irudoy/canlogger/docs/reference/README.md

# Reference Documentation

## MLVLG Format Specification (official)

- [MLG_Binary_LogFormat_2.0.pdf](MLG_Binary_LogFormat_2.0.pdf) — MLVLG v2 spec (Logger Field = 89 bytes with Category, Info Data Start = 4 bytes)

Author: Philip Tobin (EFI Analytics / TunerStudio / MegaLogViewer)

### Display value formula

```
DisplayValue = (rawValue + transform) * scale
rawValue = DisplayValue / scale - transform
```

### CRC

1-byte overflow sum of all data bytes in Logger Field Record (not including block type, counter, timestamp header).

### Timestamp in data blocks

2-byte timestamp at 10 us/bit resolution.

## rusefi Reference Implementation

Canonical MLG writer in [rusefi/rusefi](https://github.com/rusefi/rusefi/tree/master/firmware/console/binary_mlg_log) — `rusefi_mlg_types.h`, `rusefi_mlg_field.h`, `rusefi_binary_mlg_logging.{h,cpp}`.

## Hardware

- [STM32F407VET6-STM32_F4VE_V2.0_schematic.pdf](STM32F407VET6-STM32_F4VE_V2.0_schematic.pdf) — Board schematic

### Board features (from schematic)

- MCU: STM32F407VET6 (196K RAM, 512K Flash, 168MHz)
- Power: AMS1117-3.3V regulator, 5V input via header
- Crystals: 8MHz HSE (Y2), 32.768KHz LSE (Y1) for RTC
- SD card: MiniSD slot (U5) via SDIO
- USB: Mini USB (J4) as slave
- JTAG/SWD: 20-pin JTAG header (P1)
- ISP: UART1 (PA9 TX, PA10 RX) via 4-pin header (J6)
- NRF2401: 4-pin dual-row header (JP2)
- External Flash: W25Q16 (U3) SPI
- LEDs: D1, D2, D3 (active low)
- Buttons: K0, K1 (active low with pull-up), K_UP (active high), RST
- TFT LCD: 24x2 dual-row headers (J2, J3) + 16x2 header (J1)
- Boot mode: configurable via BOOT0/BOOT1 resistors
