irudoy/canlogger/docs/CONFIG_GUIDE.md

# CAN Logger: Configuration & MLG Format Guide

## Quick Start

1. Create `config.ini` on FAT32-formatted SD card (root directory)
2. Insert SD card into the logger
3. Power on — LED D2 blinks = logging active
4. Power off, eject SD — open `.mlg` files in [MegaLogViewer](https://www.efianalytics.com/MegaLogViewer/)

If there is no `config.ini` or it has errors, LEDs will indicate an error (see [HARDWARE.md](HARDWARE.md)).

## Config File Format

The config file uses INI-like syntax. It has one `[logger]` section and one or more `[field]` sections.

```ini
[logger]
interval_ms = 50
can_bitrate = 500000

[field]
can_id = 0x666
name = Coolant Temp
units = C
start_byte = 1
bit_length = 8
type = U08
scale = 1.0
offset = -40.0
digits = 0
category = Engine
```

Comments start with `#` and are ignored.

### [logger] Section

| Key | Required | Default | Description |
|-----|---|---|---|
| `interval_ms` | yes | -- | How often to write a data record (ms). 50 = 20 Hz, 10 = 100 Hz |
| `can_bitrate` | no | 500000 | CAN bus speed. Allowed: 125000, 250000, 500000, 1000000 |

### [field] Sections

Each `[field]` section defines one logged parameter. The order of sections determines the order of fields in the MLG file and in MegaLogViewer.

| Key | Required | Default | Description |
|-----|---|---|---|
| `can_id` | yes | -- | CAN ID to listen for (hex `0x...` or decimal) |
| `is_extended` | no | 0 | 1 = 29-bit extended ID (CAN 2.0B), 0 = 11-bit standard. Required for AEMnet and other extended-frame sources |
| `name` | yes | -- | Parameter name shown in MegaLogViewer (max 33 chars) |
| `units` | yes | -- | Units label (max 9 chars) |
| `start_byte` | yes | -- | Byte position in CAN data payload (0--7) |
| `start_bit` | no | 0 | Bit-within-byte position (0--7), only for sub-byte fields (`bit_length < 8`) |
| `bit_length` | yes | -- | Data width in bits: 1--7 (sub-byte), 8, 16, 32, or 64 |
| `type` | yes | -- | Data type: `U08`, `S08`, `U16`, `S16`, `U32`, `S32`, `S64`, `F32` |
| `scale` | yes | -- | Display multiplier: `display = raw * scale + offset` |
| `offset` | yes | -- | Display offset |
| `is_big_endian` | no | 0 | Byte order in CAN frame: 0 = little-endian, 1 = big-endian. Ignored for sub-byte fields |
| `digits` | no | 0 | Decimal places in MegaLogViewer |
| `display_style` | no | 0 | 0=Float, 1=Hex, 2=Bits, 4=On/Off, 5=Yes/No, 6=High/Low |
| `category` | no | *(empty)* | Group name in MegaLogViewer (max 33 chars) |
| `lut` | no | -- | Lookup table for non-linear conversion (see below) |
| `valid_min` | no | -- | Reject frames where the computed display value falls below this threshold |
| `valid_max` | no | -- | Reject frames where the computed display value exceeds this threshold |
| `invalid_strategy` | no | `last_good` | What to do on rejection: `last_good` (keep previous value), `clamp` (saturate to min/max), `skip` (do not update shadow buffer) |
| `preset` | no | `none` | Plug-in sensor-fault detector. `aem_uego` rejects raw `0xFFFF` on a 16-bit field (AEM X-Series warmup/free-air-cal/sensor-fault marker). Applies *before* `valid_min/max` |

### Constraints

- Maximum 256 fields total, up to 28 unique CAN IDs (hardware filter limit)
- `start_byte + bit_length/8` must not exceed 8 (CAN frame is 8 bytes)
- Sub-byte fields (`bit_length` 1--7) must use `type = U08` or `S08`, and `start_bit + bit_length <= 8`
- `start_bit` is only valid for sub-byte fields (`bit_length < 8`); non-zero `start_bit` with byte-aligned `bit_length` is rejected
- The same `can_id` must not appear with conflicting `is_extended` flags
- Multiple fields can reference the same `can_id`
- Field names must be unique

## Data Conversion: scale & offset

The logger stores raw integer values extracted from CAN data. MegaLogViewer displays them using:

```
DisplayValue = raw * scale + offset
```

**Examples:**

| Sensor | Raw range | Scale | Offset | Display range |
|---|---|---|---|---|
| Battery voltage | 0--255 | 0.08 | 0 | 0--20.4 V |
| Coolant temp (Nissan) | 0--255 | 1.0 | -50.0 | -50--205 C |
| RPM (16-bit) | 0--65535 | 12.5 | 0 | 0--819187 rpm |
| Ignition timing | 0--255 | -1.0 | -110.0 | -110--145 deg |

## Lookup Tables (LUT)

For non-linear sensors (NTC thermistors, non-linear pressure sensors), use a lookup table instead of simple scale/offset.

```ini
lut = input1:output1, input2:output2, ...
```

- `input` -- raw value from CAN (unsigned 16-bit, e.g. millivolts from ADC)
- `output` -- display value (signed 16-bit, e.g. degrees C)
- 2 to 16 points, sorted by ascending input
- Linear interpolation between points, clamped outside range
- When LUT is present, `scale`/`offset` are still required -- they define how the display value is stored in MLG format (`stored = display / scale - offset`)

### Example: NTC thermistor (Bosch 0261230042, 2.2k pull-up)

```ini
[field]
can_id = 0x640
name = IAT
units = C
start_byte = 0
bit_length = 16
type = S16
scale = 0.1
offset = 0.0
is_big_endian = 1
digits = 0
category = Sensors
lut = 192:120, 325:100, 428:90, 570:80, 760:70, 1014:60, 1346:50, 1765:40, 2259:30, 2807:20, 3353:10, 3848:0, 4543:-20, 4860:-40
```

Raw 2259 mV -> 30 C, raw 3000 mV -> interpolated ~16 C, raw 100 mV -> clamped 120 C.

### Example: linear MAP sensor (2-point LUT from datasheet)

```ini
[field]
can_id = 0x640
name = MAP
units = kPa
start_byte = 2
bit_length = 16
type = U16
scale = 1.0
offset = 0.0
is_big_endian = 1
digits = 0
category = Sensors
lut = 400:20, 4650:250
```

## Byte Order (Endianness)

CAN data bytes can be in little-endian (LSB first) or big-endian (MSB first) order depending on the source ECU.

- `is_big_endian = 0` (default): bytes `[low, high]` -- common in many aftermarket ECUs
- `is_big_endian = 1`: bytes `[high, low]` -- common in OEM ECUs, Nissan Consult

For 8-bit fields (`bit_length = 8`), endianness does not matter.

## Extended (29-bit) CAN IDs

Standard CAN frames use 11-bit IDs (0x000--0x7FF). CAN 2.0B extended frames use 29-bit IDs and are distinguished by the IDE bit on the wire. Sources like AEMnet (AEM gauges) and J1939 use extended IDs.

Set `is_extended = 1` to configure the hardware filter for extended frames. The same numeric `can_id` value can exist in the standard and extended ID spaces independently, so always set this flag explicitly when the source documentation specifies extended addressing.

```ini
# AEM X-Series UEGO 30-0300, AEMnet extended ID 0x180
[field]
can_id = 0x180
is_extended = 1
name = Lambda
units = λ
start_byte = 0
bit_length = 16
type = U16
is_big_endian = 1
scale = 0.0001
offset = 0.0
digits = 4
category = AEM UEGO
```

## Sub-byte (bit-level) Fields

For digital flags packed inside a single byte (ECU status bits, solenoid states, DTCs), declare each bit as its own field with `bit_length = 1` and an explicit `start_bit`.

```ini
# Nissan Consult BIT_1 register — byte 0 of 0x668
[field]
can_id = 0x668
name = Throttle Closed
units = bool
start_byte = 0
start_bit = 0       # bit 0
bit_length = 1
type = U08
scale = 1.0
offset = 0.0
category = Cansult

[field]
can_id = 0x668
name = Neutral Switch
units = bool
start_byte = 0
start_bit = 2       # bit 2
bit_length = 1
type = U08
scale = 1.0
offset = 0.0
category = Cansult
```

Bit ordering is LSB = bit 0. Sub-byte fields produce raw 0/1 values in the MLG; use `display_style = 4` (On/Off) or `5` (Yes/No) for nicer rendering in MegaLogViewer.

## Plausibility Filtering

CAN sources without per-frame integrity protection (Nissan Consult, raw OBD streams, hobbyist gauges) can emit impossible values when a single UART or bit-stuff byte is shifted. Raw RPM of 745 663 and AFR of 96 on decel fuel-cut are both real examples from production logs. MegaLogViewer auto-scales the timeline to those spikes, making the useful range unreadable.

Add three optional keys per field:

- `valid_min`, `valid_max` — bounds expressed in **display units** (the value after `scale`, `offset`, and any `lut` is applied).
- `invalid_strategy` — how to treat a rejected sample:
  - `last_good` (default) — shadow buffer keeps the previous known-good value; the MLG stream receives a flat-line until a plausible frame arrives.
  - `clamp` — saturate the value to whichever bound was crossed. Useful when you want the chart to show "at limit" rather than a gap.
  - `skip` — do not update the shadow buffer at all. Identical to `last_good` in the current writer (shadow stays), kept as an explicit intent marker for future per-field change-detection.

Sensor-specific fault encodings that cannot be expressed as a bound are handled by presets:

- `preset = aem_uego` — on a 16-bit field, rejects raw `0xFFFF`. AEM X-Series UEGO gauges emit this value during warmup, free-air calibration, and any sensor fault; without it decel fuel-cut produces a spike of AFR ≈ 96.

```ini
# AEM UEGO: reject sensor-fault marker and clamp physical range
[field]
can_id = 0x180
is_extended = 1
name = AFR
units = :1
start_byte = 0
bit_length = 16
type = U16
is_big_endian = 1
scale = 0.001465
preset = aem_uego
valid_min = 7
valid_max = 22
invalid_strategy = last_good

# RPM: any value > 9000 is a UART framing shift on the cansult side
[field]
can_id = 0x667
name = RPM
units = rpm
start_byte = 1
bit_length = 16
type = U16
is_big_endian = 1
scale = 12.5
valid_max = 9000
invalid_strategy = last_good
```

Order of evaluation: extract → preset check → LUT → valid_min/max check → write to shadow (or apply strategy).

## GPS

The logger supports an optional u-blox NEO-6M (or compatible NMEA-0183) receiver wired to USART3 at 9600 8N1. When enabled, GPS fields appear in the MLG file alongside CAN fields.

### Enable block

Adding `[gps] enable = 1` turns the feature on and auto-injects a minimal set of GPS fields at the end of the `[field]` list:

```ini
[gps]
enable = 1
```

| Auto-injected field | Type | Units | Source |
|---|---|---|---|
| `gps_lat` | F32  | deg | $xxGGA / $xxRMC — decimal degrees, south negative |
| `gps_lon` | F32  | deg | $xxGGA / $xxRMC — decimal degrees, west negative  |
| `gps_alt` | F32  | m | $xxGGA altitude MSL |
| `gps_speed_kmh` | F32  | km/h  | $xxRMC speed (knots converted) |
| `gps_fix` | U08  | -- | 0 = no fix, 1 = GPS, 2 = DGPS, 6 = estimated |

Each field's value stays at its previous reading until the corresponding NMEA sentence arrives with a valid fix — so `gps_lat` reads 0 on boot and flips to the receiver's decimal-degree output once the module acquires satellites. `gps_fix = 0` is the reliable signal that the other fields aren't trustworthy yet.

### Extra GPS fields via `source = gps:*`

To log additional GPS data beyond the five defaults, add `[field]` sections with `source = gps:<tag>` in place of `can_id`. The parser skips the CAN-frame geometry checks for these fields.

```ini
[field]
name = gps_sats
units = cnt
type = U08
source = gps:sats

[field]
name = gps_hdop
units = --
type = F32
digits = 1
source = gps:hdop

[field]
name = gps_course
units = deg
type = F32
digits = 1
source = gps:course
```

Supported tags: `lat`, `lon`, `alt`, `speed_ms`, `speed_kmh`, `course`, `sats`, `hdop`, `fix`, `year`, `month`, `day`, `hour`, `minute`, `second`.

Declaring `source = gps:lat` (or any of the five defaults) suppresses the auto-inject for that slot, so your customized field replaces the default — use this to change the type, digits, name, or apply a non-unit `scale`.

### One-shot RTC sync

On the first NMEA sentence with both a valid fix and a full date+time, the firmware syncs the RTC once per boot. CDC `settime` still works as a manual override; the auto-sync does not fight it after it has fired once.

### CDC commands

- `gps` — one-shot snapshot of the parsed state: fix quality, satellite count, lat/lon, altitude, speed, course, HDOP, UTC timestamp, and parser counters (ok / bad-checksum / ignored / line-buffer overflow).
- `gps_raw` — toggle: when ON, every byte received on USART3 is echoed to the CDC stdout. Useful for diagnosing antenna / cabling issues before you rely on parser output.

## Choosing the Right Data Type

| CAN data | Type | Bit length | Notes |
|---|---|---|---|
| Unsigned byte (0--255) | `U08` | 8 | Most common for single-byte values |
| Signed byte (-128--127) | `S08` | 8 | Temperature with negative range |
| Unsigned 16-bit (0--65535) | `U16` | 16 | RPM, injection time, ADC values |
| Signed 16-bit (-32768--32767) | `S16` | 16 | Temperature from LUT |
| Unsigned 32-bit | `U32` | 32 | Odometer, counters |
| Signed 32-bit | `S32` | 32 | |
| Signed 64-bit | `S64` | 64 | Uses full CAN frame |
| 32-bit float | `F32` | 32 | IEEE 754 floating point |

## MLG File Format (for users)

The logger writes `.mlg` files in **MLVLG v2** format, compatible with [MegaLogViewer](https://www.efianalytics.com/MegaLogViewer/) (free and HD versions).

- Files are named sequentially: `LOG_0001.MLG`, `LOG_0002.MLG`, ...
- File rotation at 4 MB -- new file is started automatically
- All data is big-endian
- Each data record contains a snapshot of all field values at the time of writing

### Opening in MegaLogViewer

1. File -> Open Log File -> select `.mlg` file
2. All configured fields appear in the field list with their names, units, and categories
3. Drag fields to the graph area to plot
4. Use categories to group related fields

### Display formula

MegaLogViewer applies the formula from the MLG header:

```
DisplayValue = (storedValue + transform) * scale
```

This is set up automatically by the logger from your config -- you don't need to configure anything in MegaLogViewer.

### Built-in `Date` field and HH:MM:SS via calculated fields

Each record includes a synthetic `Date` field (U32 unix timestamp, `MLG_DATE`
display style). MegaLogViewer renders it as a calendar date only (e.g.
`Apr 14, 2026`) — the MLG spec has no native HH:MM:SS style.

To display the wall-clock time, add **calculated fields** in your viewer.
Calculated fields are numeric only — string formatting like `"HH:MM:SS"` is
not supported by either viewer.

#### MegaLogViewer (Optional Fields → Custom Fields)

MLV supports the `%` (modulo) operator.

Single packed HHMMSS integer — one row in the value panel:

```
TimeHHMMSS = floor(([Date] % 86400) / 3600) * 10000
           + floor(([Date] % 3600)  / 60)   * 100
           + ([Date] % 60)
```

Displays as `171642`, read as `17:16:42`.

Three separate fields — three rows, each a plain number (`17`, `16`, `42`):

```
Hour   = floor(([Date] % 86400) / 3600)
Minute = floor(([Date] % 3600)  / 60)
Second = [Date] % 60
```

#### UltraLog (Computed Channels)

UltraLog's expression engine (`meval`) supports `floor`/`ceil`/`round`/`trunc`
but **does not have a `%` operator** — use `x - floor(x/y)*y` for modulo.

Single packed HHMMSS integer:

```
TimeHHMMSS = floor((Date - floor(Date/86400)*86400) / 3600) * 10000
           + floor((Date - floor(Date/3600)*3600)   / 60)   * 100
           + (Date - floor(Date/60)*60)
```

Three separate fields:

```
Hour   = floor((Date - floor(Date/86400)*86400) / 3600)
Minute = floor((Date - floor(Date/3600)*3600)   / 60)
Second = Date - floor(Date/60)*60
```

## Complete Example: Nissan Consult via cansult

This config logs 11 parameters from a Nissan ECU using the [cansult](../cansult/) bridge (Consult protocol -> CAN bus).

```ini
[logger]
interval_ms = 50
can_bitrate = 500000

# Connection state
[field]
can_id = 0x665
name = State
units = raw
start_byte = 0
bit_length = 8
type = U08
scale = 1.0
offset = 0.0
digits = 0
category = Cansult

# Battery voltage: raw 0-255, display 0-20.4V
[field]
can_id = 0x666
name = Battery
units = V
start_byte = 0
bit_length = 8
type = U08
scale = 0.08
offset = 0.0
digits = 1
category = Engine

# Coolant temperature: raw 0-255, display -50 to 205 C
[field]
can_id = 0x666
name = Coolant
units = C
start_byte = 1
bit_length = 8
type = U08
scale = 1.0
offset = -50.0
digits = 0
category = Engine

# RPM: 16-bit big-endian, raw * 12.5 = RPM
[field]
can_id = 0x667
name = RPM
units = rpm
start_byte = 1
bit_length = 16
type = U16
scale = 12.5
offset = 0.0
is_big_endian = 1
digits = 0
category = Engine

# Vehicle speed: raw * 2 = km/h
[field]
can_id = 0x667
name = Speed
units = km/h
start_byte = 0
bit_length = 8
type = U08
scale = 2.0
offset = 0.0
digits = 0
category = Vehicle
```

## Troubleshooting

| Symptom | Cause | Fix |
|---|---|-----|
| LED error on startup | No `config.ini` on SD root | Create config file, check FAT32 format |
| LED error on startup | Syntax error in config | Check field names, missing values, typos |
| All values zero | Wrong `can_id` | Verify CAN IDs from your source device |
| Values look wrong | Wrong `is_big_endian` | Try toggling between 0 and 1 |
| Values look wrong | Wrong `scale`/`offset` | Check ECU documentation for conversion formula |
| Values look wrong | Wrong `start_byte` | Verify byte position in CAN data payload |
| No log files | SD card issue | Use FAT32-formatted card, check contacts |
| Short log files | Power loss | Use stable power supply, graceful shutdown with K1 button |
