irudoy/canlogger/docs/ppk-measurements/ppk-20260410T144323.png

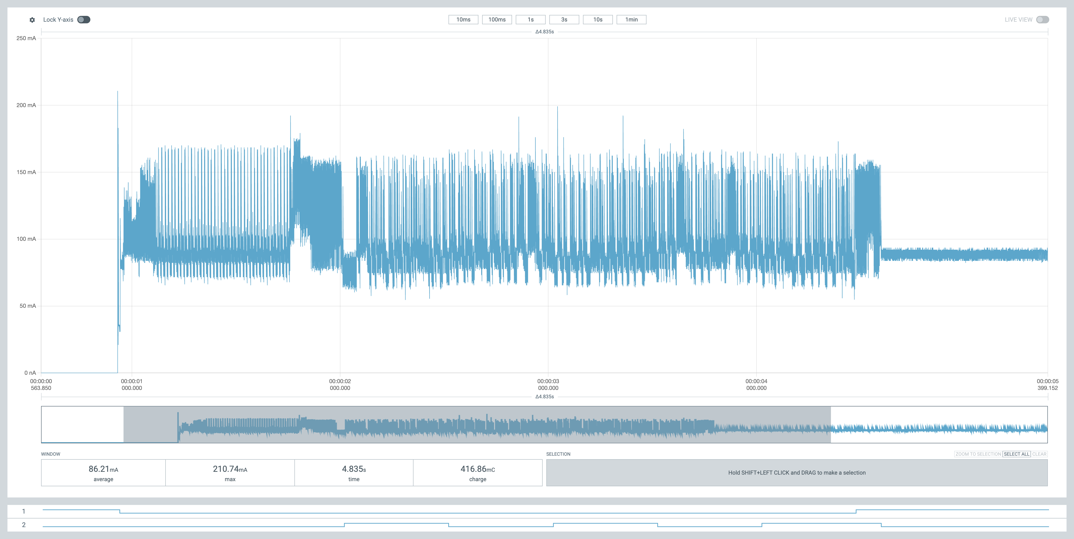
docs/ppk-measurements/ppk-20260410T144323.png
