irudoy/canlogger/docs/ppk-measurements/ppk-20260410T144636.png

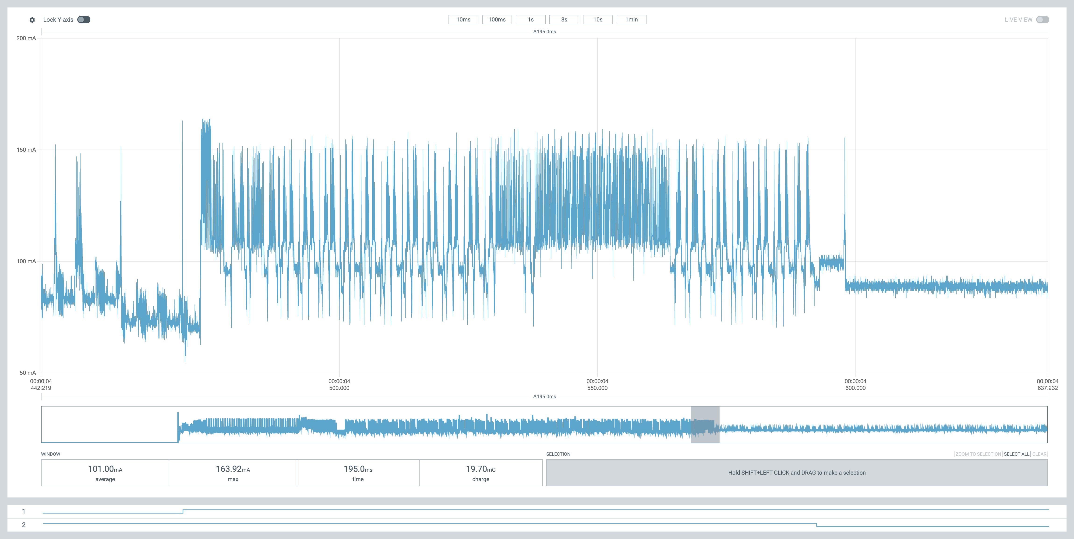
docs/ppk-measurements/ppk-20260410T144636.png
