irudoy/canlogger/docs/ppk-measurements/ppk-20260410T145153.png

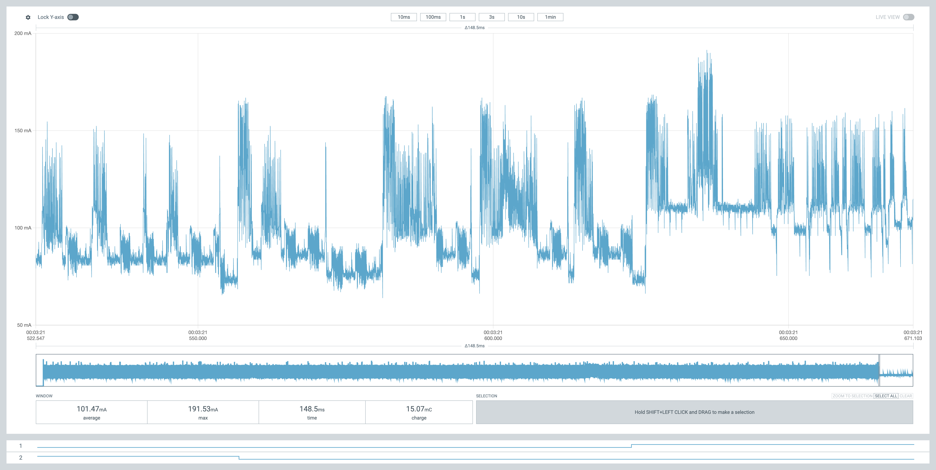
docs/ppk-measurements/ppk-20260410T145153.png
