irudoy/canlogger/firmware/Src/main.c

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
/* Includes ------------------------------------------------------------------*/
#include "main.h"
#include "cmsis_os.h"
#include "fatfs.h"
#include "usb_device.h"

/* USER CODE BEGIN Includes */
#include <string.h>
#include "log_writer.h"
#include "can_drv.h"
#include "ring_buf.h"
#include "can_map.h"
#include "debug_out.h"
#include "demo_gen.h"
#include "demo_can.h"
#include "vin_sense.h"
#include "bkp_log.h"
#include "gps_drv.h"
/* USER CODE END Includes */

/* USER CODE BEGIN PD */
#define VIN_SENSE_CHECK_MS    100   /* poll interval */
/* USER CODE END PD */

ADC_HandleTypeDef hadc1;

CAN_HandleTypeDef hcan1;

RTC_HandleTypeDef hrtc;

SD_HandleTypeDef hsd;
DMA_HandleTypeDef hdma_sdio_rx;
DMA_HandleTypeDef hdma_sdio_tx;

UART_HandleTypeDef huart3;
DMA_HandleTypeDef hdma_usart3_rx;

/* Definitions for defaultTask */
osThreadId_t defaultTaskHandle;
const osThreadAttr_t defaultTask_attributes = {
  .name = "defaultTask",
  .stack_size = 512 * 4,
  .priority = (osPriority_t) osPriorityNormal,
};
/* USER CODE BEGIN PV */
volatile uint8_t lw_shutdown = 0;
volatile uint8_t sd_stopped = 0;  // set by task_sd after lw_stop completes
volatile uint8_t vin_triggered_shutdown = 0;  // 1 = VIN outage (auto-resume), 0 = CDC `stop`
// Marker request: 0=none, 1=K0 press ("btn"), 2=CDC `mark` (marker_cdc_text).
// Set by EXTI ISR or CDC task, consumed by task_sd.
volatile uint8_t marker_request = 0;
char marker_cdc_text[50];  // filled by CDC before setting marker_request=2
static ring_Buffer can_rx_buf;
static cfg_Config config __attribute__((section(".ccmram")));
static can_FieldValues field_values;
static uint32_t can_frames_processed = 0;
volatile int init_ok = 0;
// Demo mode helper arrays (extracted from config for demo_generate)
static uint8_t demo_field_types[CFG_MAX_FIELDS];
static float demo_field_scales[CFG_MAX_FIELDS];
static float demo_field_offsets[CFG_MAX_FIELDS];

// FreeRTOS: shadow mutex guards field_values between task_producer and task_sd
osMutexId_t shadow_mutex;
static const osMutexAttr_t shadow_mutex_attr = {
  .name = "shadowMutex"
};

// FreeRTOS: SD writer task
osThreadId_t sdTaskHandle;
static const osThreadAttr_t sdTask_attributes = {
  .name = "sdTask",
  .stack_size = 4096,
  .priority = (osPriority_t) osPriorityBelowNormal,
};
void SdTaskEntry(void *argument);
/* USER CODE END PV */

void SystemClock_Config(void);
static void MX_GPIO_Init(void);
static void MX_DMA_Init(void);
static void MX_CAN1_Init(void);
static void MX_SDIO_SD_Init(void);
static void MX_RTC_Init(void);
static void MX_ADC1_Init(void);
static void MX_USART3_UART_Init(void);
void StartDefaultTask(void *argument);

static void MX_NVIC_Init(void);
/* USER CODE BEGIN 0 */
void HAL_GPIO_EXTI_Callback(uint16_t GPIO_Pin) {
  if (GPIO_Pin == USR_BTN_3_K1_Pin) {
    lw_shutdown = 1;
    HAL_GPIO_WritePin(LED_1_GPIO_Port, LED_1_Pin, GPIO_PIN_SET); // D2 off (active-low)
  } else if (GPIO_Pin == USR_BTN_4_K0_Pin) {
    // Debounce: any edge (including release-bounce that also trips FALLING)
    // extends the blackout. Window must exceed typical hold + release time.
    static uint32_t k0_last_tick = 0;
    uint32_t now = HAL_GetTick();
    uint32_t since = now - k0_last_tick;
    k0_last_tick = now;
    if (since < 300) return;
    if (marker_request == 0) marker_request = 1;  // drop if SD hasn't consumed yet
  }
}
/* USER CODE END 0 */

/**
  * @brief  The application entry point.
  * @retval int
  */
int main(void)
{

  /* MCU Configuration--------------------------------------------------------*/

  /* Reset of all peripherals, Initializes the Flash interface and the Systick. */
  HAL_Init();

  /* Configure the system clock */
  SystemClock_Config();

  /* Initialize all configured peripherals */
  MX_GPIO_Init();
  MX_DMA_Init();
  MX_CAN1_Init();
  MX_SDIO_SD_Init();
  MX_FATFS_Init();
  MX_RTC_Init();
  MX_ADC1_Init();
  MX_USART3_UART_Init();

  /* Initialize interrupts */
  MX_NVIC_Init();
  /* USER CODE BEGIN 2 */
  bkp_log_init();  // increment session counter in BKP_DR1
  ring_buf_init(&can_rx_buf);
  /* SD/FatFS init moved to StartDefaultTask — requires scheduler running
   * (RTOS sd_diskio template checks osKernelGetState before BSP_SD_Init). */
  /* USER CODE END 2 */

  /* Init scheduler */
  osKernelInitialize();

  /* USER CODE BEGIN RTOS_MUTEX */
  shadow_mutex = osMutexNew(&shadow_mutex_attr);
  /* USER CODE END RTOS_MUTEX */

  /* USER CODE BEGIN RTOS_SEMAPHORES */
  /* add semaphores, ... */
  /* USER CODE END RTOS_SEMAPHORES */

  /* USER CODE BEGIN RTOS_TIMERS */
  /* start timers, add new ones, ... */
  /* USER CODE END RTOS_TIMERS */

  /* USER CODE BEGIN RTOS_QUEUES */
  /* add queues, ... */
  /* USER CODE END RTOS_QUEUES */

  /* Create the thread(s) */
  /* creation of defaultTask */
  defaultTaskHandle = osThreadNew(StartDefaultTask, NULL, &defaultTask_attributes);

  /* USER CODE BEGIN RTOS_THREADS */
  sdTaskHandle = osThreadNew(SdTaskEntry, NULL, &sdTask_attributes);
  /* USER CODE END RTOS_THREADS */

  /* USER CODE BEGIN RTOS_EVENTS */
  /* add events, ... */
  /* USER CODE END RTOS_EVENTS */

  /* Start scheduler */
  osKernelStart();

  /* We should never get here as control is now taken by the scheduler */

  /* Infinite loop */
  /* USER CODE BEGIN WHILE */
  while (1)
  {
    /* Dead code — scheduler never returns. Kept for CubeMX marker compliance. */
    /* USER CODE END WHILE */

    /* USER CODE BEGIN 3 */
  }
  /* USER CODE END 3 */
}

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
/* USER CODE BEGIN 4 */
void SdTaskEntry(void *argument)
{
  (void)argument;
  static uint8_t snapshot[CAN_MAP_MAX_RECORD_SIZE];
  uint32_t next_wake = 0;

  while (!lw_shutdown) {
    if (!init_ok || lw_is_error()) {
      osDelay(100);
      next_wake = 0;  // reset periodic base after wait
      continue;
    }

    // Periodic timing via osDelayUntil — drift-free
    if (next_wake == 0) {
      next_wake = osKernelGetTickCount();
    }
    next_wake += config.log_interval_ms;
    osDelayUntil(next_wake);

    if (lw_shutdown) break;

    // Snapshot shadow buffer under mutex
    osMutexAcquire(shadow_mutex, osWaitForever);
    size_t rec_len = field_values.record_length;
    memcpy(snapshot, field_values.values, rec_len);
    osMutexRelease(shadow_mutex);

    // Marker drained before snapshot so it lands at the chronologically
    // correct spot between data blocks.
    if (marker_request) {
      const char* msg = (marker_request == 2) ? marker_cdc_text : "btn";
      lw_write_marker(msg);
      marker_request = 0;
    }

    lw_write_snapshot(snapshot, rec_len);
  }

  // Graceful shutdown: flush and close
  if (init_ok) lw_stop();

  // Signal task_producer that SD is fully flushed — safe to reset MCU now.
  sd_stopped = 1;
  osThreadExit();
}
/* USER CODE END 4 */

/* USER CODE BEGIN Header_StartDefaultTask */
/**
  * @brief  Function implementing the defaultTask thread.
  * @param  argument: Not used
  * @retval None
  */
/* USER CODE END Header_StartDefaultTask */
void StartDefaultTask(void *argument)
{
  /* init code for USB_DEVICE */
  MX_USB_DEVICE_Init();
  /* USER CODE BEGIN 5 */
  // Init SD, read config, write MLG header (must run after scheduler start —
  // RTOS sd_diskio template requires osKernelRunning for BSP_SD_Init)
  init_ok = (lw_init(&config, &field_values) == 0);

  gps_drv_init();

  // Extract field metadata for demo generator
  if (init_ok && config.demo) {
    for (int i = 0; i < config.num_fields; i++) {
      demo_field_types[i] = config.fields[i].type;
      demo_field_scales[i] = config.fields[i].scale;
      demo_field_offsets[i] = config.fields[i].offset;
    }
  }

  if (init_ok) {
    if (config.num_can_ids > 0) {
      can_drv_init(&can_rx_buf, &config);
      can_drv_start();
    }
  } else {
    config.can_bitrate = 500000;
    config.num_can_ids = 0;
    can_drv_init(&can_rx_buf, &config);
    can_drv_start();
  }

  /* task_producer: drain CAN ring buffer, update shadow, handle debug CLI */
  for(;;)
  {
    if (lw_shutdown) {
      can_drv_stop();
      // Wait for task_sd to flush SD before MCU reset — resetting mid-write
      // corrupts the file. Cap wait at 2s: if lw_stop wedges (card removed,
      // HAL stuck), reset anyway so we don't drain the supercap forever.
      uint32_t deadline = HAL_GetTick() + 2000;
      while (!sd_stopped && HAL_GetTick() < deadline) osDelay(10);

      // CDC `stop` (vin_triggered_shutdown=0) just halts — user wants to
      // flash or remove the card. VIN-triggered shutdown waits for power
      // to return, then resets so logging auto-resumes.
      if (!vin_triggered_shutdown) osThreadExit();

      int high_count = 0;
      for (;;) {
        osDelay(VIN_SENSE_CHECK_MS);
        vin_sense_poll();
        if (vin_sense_mv >= VIN_SENSE_THRESHOLD_MV) {
          if (++high_count >= 3) NVIC_SystemReset();
        } else {
          high_count = 0;
        }
      }
    }

    // Pack demo data into CAN frames (if demo + ring buf mode)
    if (init_ok && config.demo && config.demo_gen.use_ring_buf) {
      demo_pack_can_frames(&config, &can_rx_buf, HAL_GetTick());
    }

    // Drain GPS DMA outside shadow_mutex: gps_drv_poll() touches only
    // task_producer-local state, and when `gps_raw` is ON it also does
    // per-byte putchar() to CDC — holding shadow_mutex through that stalls
    // task_sd's field_values snapshot for the duration of the USB TX.
    gps_drv_poll();

    // Drain CAN ring buffer → update shadow under mutex
    {
      can_Frame frame;
      osMutexAcquire(shadow_mutex, osWaitForever);
      if (init_ok && config.gps_enabled) {
        can_map_update_gps(&field_values, &config, gps_drv_state());
      }
      while (ring_buf_pop(&can_rx_buf, &frame) == 0) {
        if (init_ok) can_map_process(&field_values, &config, &frame);
        can_frames_processed++;
        debug_out_set_can(frame.id, frame.data, frame.dlc);
      }
      // Direct demo for fields without CAN IDs (legacy path)
      if (init_ok && config.demo && !config.demo_gen.use_ring_buf) {
        demo_generate(&config.demo_gen,
                      field_values.values, field_values.record_length,
                      demo_field_types, demo_field_scales, demo_field_offsets,
                      config.num_fields, HAL_GetTick());
        field_values.updated = 1;
      }
      osMutexRelease(shadow_mutex);
    }

    // One-shot RTC sync on first GPS fix with date+time. `gps_rtc_synced`
    // latches for the life of this boot so the loop doesn't keep re-setting
    // the RTC every iteration. CDC `settime` still works as a manual override.
    {
      static uint8_t gps_rtc_synced = 0;
      if (!gps_rtc_synced) {
        const gps_State* gs = gps_drv_state();
        if (gs->has_fix && gs->has_date && gs->has_time) {
          #define BCD(v) (uint8_t)(((v) / 10) << 4 | ((v) % 10))
          RTC_TimeTypeDef t = {
            .Hours = BCD(gs->hour), .Minutes = BCD(gs->minute), .Seconds = BCD(gs->second),
            .DayLightSaving = RTC_DAYLIGHTSAVING_NONE,
            .StoreOperation = RTC_STOREOPERATION_RESET,
          };
          RTC_DateTypeDef d = {
            .WeekDay = RTC_WEEKDAY_MONDAY,
            .Month = BCD(gs->month), .Date = BCD(gs->day),
            .Year = BCD(gs->year % 100),
          };
          #undef BCD
          if (HAL_RTC_SetTime(&hrtc, &t, RTC_FORMAT_BCD) == HAL_OK &&
              HAL_RTC_SetDate(&hrtc, &d, RTC_FORMAT_BCD) == HAL_OK) {
            gps_rtc_synced = 1;
          }
        }
      }
    }

    debug_out_tick(can_frames_processed, config.num_fields, init_ok);
    debug_cmd_poll(&config, init_ok, &can_rx_buf);
    lw_update_leds();

    // VIN_SENSE: check every VIN_SENSE_CHECK_MS
    {
      static uint32_t next_vin_check = 0;
      uint32_t now = HAL_GetTick();
      if (now >= next_vin_check) {
        vin_sense_poll();
        next_vin_check = now + VIN_SENSE_CHECK_MS;
      }
    }

    osDelay(1);
  }
  /* USER CODE END 5 */
}

/**
  * @brief  Period elapsed callback in non blocking mode
  * @note   This function is called  when TIM6 interrupt took place, inside
  * HAL_TIM_IRQHandler(). It makes a direct call to HAL_IncTick() to increment
  * a global variable "uwTick" used as application time base.
  * @param  htim : TIM handle
  * @retval None
  */
void HAL_TIM_PeriodElapsedCallback(TIM_HandleTypeDef *htim)
{
  if (htim->Instance == TIM6)
  {
    HAL_IncTick();
  }
}

/**
  * @brief  This function is executed in case of error occurrence.
  * @retval None
  */
void Error_Handler(void)
{
  /* USER CODE BEGIN Error_Handler_Debug */
  /* User can add his own implementation to report the HAL error return state */
  __disable_irq();
  while (1)
  {
  }
  /* USER CODE END Error_Handler_Debug */
}
#ifdef USE_FULL_ASSERT
/**
  * @brief  Reports the name of the source file and the source line number
  *         where the assert_param error has occurred.
  * @param  file: pointer to the source file name
  * @param  line: assert_param error line source number
  * @retval None
  */
void assert_failed(uint8_t *file, uint32_t line)
{
  /* USER CODE BEGIN 6 */
  /* User can add his own implementation to report the file name and line number,
     ex: printf("Wrong parameters value: file %s on line %d\r\n", file, line) */
  /* USER CODE END 6 */
}
#endif /* USE_FULL_ASSERT */
