irudoy/canlogger/firmware/canlogger.ioc

Mcu.UserName=STM32F407VETx
PA0-WKUP.Signal=ADCx_IN0
PA11.Signal=USB_OTG_FS_DM
PA12.Signal=USB_OTG_FS_DP
PA13.Signal=SYS_JTMS-SWDIO
PA14.Signal=SYS_JTCK-SWCLK
PA6.GPIO_Label=LED_1
PA6.Signal=GPIO_Output
PA7.GPIO_Label=LED_2
PA7.Signal=GPIO_Output
PB10.Signal=USART3_TX
PB11.Signal=USART3_RX
PB8.Signal=CAN1_RX
PB9.Signal=CAN1_TX
PC10.Signal=SDIO_D2
PC11.Signal=SDIO_D3
PC12.Signal=SDIO_CK
PC14-OSC32_IN.Signal=RCC_OSC32_IN
PC15-OSC32_OUT.Signal=RCC_OSC32_OUT
PC8.Signal=SDIO_D0
PC9.Signal=SDIO_D1
PD2.Signal=SDIO_CMD
PE3.GPIO_Label=USR_BTN_3_K1
PE3.Signal=GPXTI3
PE4.GPIO_Label=USR_BTN_4_K0
PE4.Signal=GPXTI4
PH0-OSC_IN.Signal=RCC_OSC_IN
PH1-OSC_OUT.Signal=RCC_OSC_OUT
