irudoy/canlogger/firmware/Inc/main.h

#define USR_BTN_3_K1_Pin GPIO_PIN_3
#define USR_BTN_3_K1_GPIO_Port GPIOE
#define USR_BTN_3_K1_EXTI_IRQn EXTI3_IRQn
#define USR_BTN_4_K0_Pin GPIO_PIN_4
#define USR_BTN_4_K0_GPIO_Port GPIOE
#define USR_BTN_4_K0_EXTI_IRQn EXTI4_IRQn
#define LED_1_Pin GPIO_PIN_6
#define LED_1_GPIO_Port GPIOA
#define LED_2_Pin GPIO_PIN_7
#define LED_2_GPIO_Port GPIOA
#define VIN_SENSE_THRESHOLD_MV 2000   /* ~4.0V DC-DC out (divider 1:2) */
