irudoy/canlogger/firmware/Src/log_writer.c

#include "log_writer.h"

#include <stdio.h>
#include <string.h>
#include "main.h"
#include "cmsis_os2.h"
#include "mlvlg.h"
#include "sd_write_dma.h"
#include "bkp_log.h"

#define LED1 1
#define LED2 2
#define LED_ON 0
#define LED_OFF 1
#define BLINK_INTERVAL_NORMAL 500
#define BLINK_INTERVAL_ERROR 100
#define MARKER_BLINK_INTERVAL 75
#define MARKER_BLINK_TOGGLES 2
#define MAX_FILE_SIZE (32 * 1024 * 1024)
#define MAX_ERROR_COUNT 5
#define CONFIG_FILE_NAME "config.ini"

extern RTC_HandleTypeDef hrtc;

typedef struct {
  uint8_t year, month, day, hour, minute, second;
} DateTime;

static FIL log_file_obj;
static char log_file_name[32];
static uint32_t last_tick_led1 = 0;
static uint32_t last_tick_led2 = 0;
static uint8_t marker_blink_remaining = 0;
static int error_state = 0;
static int paused = 0;
static uint32_t file_counter = 0;
static int error_count = 0;
static uint32_t recovery_count = 0;
static FRESULT last_error = FR_OK;
static const char* last_error_at = "";
// Reason for the most recent recover_file() trigger (even if recovery
// succeeded). Lets us tell f_sync failures apart from f_write failures.
static FRESULT last_rec_res = FR_OK;
static const char* last_rec_at = "";
static uint8_t block_counter = 0;
static uint32_t last_log_tick = 0;
// Flips to 1 after a successful f_sync in the current file's lifetime.
// Gates the truncate/sync calls in recover_file() — if we've never had a
// clean sync, the FAT state is suspect and further ops risk hanging SDIO.
static uint8_t had_clean_sync = 0;

// Pointer to config (set at init, used for MLG header writing)
static const cfg_Config* cached_cfg = NULL;
static size_t record_length = 0;

static uint8_t write_buf[512] __attribute__((aligned(4)));

// I/O buffer: accumulate records, write to SD in larger chunks
#define IO_BUF_SIZE 4096
static uint8_t io_buf[IO_BUF_SIZE] __attribute__((aligned(4)));
static uint16_t io_pos = 0;

static void get_current_datetime(DateTime* dt);
static uint32_t datetime_to_unix(const DateTime* dt);
static void set_led(int led, int state);
static void toggle_led(int led, uint32_t* last_tick, uint32_t interval);
static FRESULT create_new_log_file(void);
static void set_error_state(FRESULT res, const char* at);
static FRESULT flush_io_buf(void);
static FRESULT recover_file(void);
static FRESULT handle_error(FRESULT res, const char* at);

// Synthetic "Date" field prepended to every record: absolute wall-clock
// time from RTC. Gives MegaLogViewer a real timeline instead of the 10us
// counter that wraps every 655 ms.
#define DATE_FIELD_SIZE 4

static FRESULT write_mlg_file_header(void) {
  uint16_t nf = (uint16_t)(cached_cfg->num_fields + 1);
  uint32_t data_begin = MLG_HEADER_SIZE + nf * MLG_FIELD_SIZE;

  DateTime dt;
  get_current_datetime(&dt);

  mlg_Header header = {
    .file_format = "MLVLG",
    .format_version = 2,
    .timestamp = datetime_to_unix(&dt),
    .info_data_start = 0,
    .data_begin_index = data_begin,
    .record_length = (uint16_t)(record_length + DATE_FIELD_SIZE),
    .num_fields = nf
  };

  int ret = mlg_write_header(write_buf, sizeof(write_buf), &header);
  if (ret < 0) return FR_INT_ERR;

  UINT bw;
  FRESULT res = f_write(&log_file_obj, write_buf, ret, &bw);
  if (res != FR_OK) return res;

  // Synthetic Date field (first in record).
  {
    mlg_Field mf;
    memset(&mf, 0, sizeof(mf));
    mf.type = MLG_U32;
    mf.display_style = MLG_DATE;
    mf.scale = 1.0f;
    mf.transform = 0.0f;
    mf.digits = 0;
    strncpy(mf.name, "Date", MLG_FIELD_NAME_SIZE - 1);
    strncpy(mf.units, "sec", MLG_FIELD_UNITS_SIZE - 1);
    strncpy(mf.category, "Time", MLG_FIELD_CATEGORY_SIZE - 1);
    ret = mlg_write_field(write_buf, sizeof(write_buf), &mf);
    if (ret < 0) return FR_INT_ERR;
    res = f_write(&log_file_obj, write_buf, ret, &bw);
    if (res != FR_OK) return res;
  }

  for (int i = 0; i < cached_cfg->num_fields; i++) {
    const cfg_Field* cf = &cached_cfg->fields[i];
    mlg_Field mf;
    memset(&mf, 0, sizeof(mf));
    mf.type = cf->type;
    mf.display_style = cf->display_style;
    mf.scale = cf->scale;
    mf.transform = cf->offset;
    mf.digits = cf->digits;
    strncpy(mf.name, cf->name, MLG_FIELD_NAME_SIZE - 1);
    strncpy(mf.units, cf->units, MLG_FIELD_UNITS_SIZE - 1);
    strncpy(mf.category, cf->category, MLG_FIELD_CATEGORY_SIZE - 1);

    ret = mlg_write_field(write_buf, sizeof(write_buf), &mf);
    if (ret < 0) return FR_INT_ERR;
    res = f_write(&log_file_obj, write_buf, ret, &bw);
    if (res != FR_OK) return res;
  }

  return FR_OK;
}

// Callback for cfg_parse_stream: read one line from FatFs file
static int sd_readline(char* buf, int max_len, void* ctx) {
  FIL* f = (FIL*)ctx;
  if (f_gets(buf, max_len, f) == NULL) return -1;
  return strlen(buf);
}

int lw_init(cfg_Config* cfg_out, can_FieldValues* fv_out) {
  // Mount SD (retry — card may need time after cold start)
  FRESULT res = FR_NOT_READY;
  for (int attempt = 0; attempt < 5; attempt++) {
    res = f_mount(&SDFatFS, (TCHAR const *)SDPath, 1);
    if (res == FR_OK) break;
    f_mount(0, "", 0);  // unmount before retry
    osDelay(200);
  }
  if (res != FR_OK) {
    set_error_state(res, "mount");
    return -1;
  }

  // Read and parse config file (streamed, no full-file buffer)
  FIL cfg_file;
  res = f_open(&cfg_file, CONFIG_FILE_NAME, FA_READ);
  if (res != FR_OK) {
    set_error_state(res, "cfg_open");
    return -1;
  }

  int parse_ret = cfg_parse_stream(sd_readline, &cfg_file, cfg_out);
  f_close(&cfg_file);
  if (parse_ret != CFG_OK) {
    set_error_state(FR_INT_ERR, "cfg_parse");
    return -1;
  }

  // Cache config pointer for MLG header writing
  cached_cfg = cfg_out;

  // Init field values shadow buffer
  if (can_map_init(fv_out, cfg_out) != 0) {
    set_error_state(FR_INT_ERR, "can_init");
    return -1;
  }
  record_length = fv_out->record_length;

  // Create first log file
  set_led(LED1, LED_ON);
  res = create_new_log_file();
  if (res != FR_OK) {
    set_error_state(res, "create");
    return -1;
  }

  last_log_tick = HAL_GetTick();
  return 0;
}

FRESULT lw_write_snapshot(const uint8_t* values, size_t rec_length) {
  if (error_state || paused) return FR_OK;

  uint16_t timestamp_10us = (uint16_t)(((uint64_t)HAL_GetTick() * 100) & 0xFFFF);

  // Build a combined record: [Date U32 BE][config fields...].
  static uint8_t rec_buf[CAN_MAP_MAX_RECORD_SIZE + DATE_FIELD_SIZE]
                 __attribute__((aligned(4)));
  DateTime dt;
  get_current_datetime(&dt);
  uint32_t unix_ts = datetime_to_unix(&dt);
  rec_buf[0] = (uint8_t)(unix_ts >> 24);
  rec_buf[1] = (uint8_t)(unix_ts >> 16);
  rec_buf[2] = (uint8_t)(unix_ts >> 8);
  rec_buf[3] = (uint8_t)(unix_ts);
  memcpy(rec_buf + DATE_FIELD_SIZE, values, rec_length);

  int ret = mlg_write_data_block(write_buf, sizeof(write_buf),
                                  block_counter++, timestamp_10us,
                                  rec_buf, rec_length + DATE_FIELD_SIZE);
  if (ret < 0) return FR_INT_ERR;

  // Accumulate in I/O buffer, flush when full
  if (io_pos + ret > IO_BUF_SIZE) {
    FRESULT res = flush_io_buf();
    if (res != FR_OK) return res;
  }
  memcpy(io_buf + io_pos, write_buf, ret);
  io_pos += ret;

  // Sync periodically (every 100 blocks)
  static uint32_t snap_sync_counter = 0;
  if (++snap_sync_counter % 100 == 0) {
    FRESULT res = flush_io_buf();
    if (res != FR_OK) return res;
    res = f_sync(&log_file_obj);
    if (res != FR_OK) {
      last_rec_res = res;
      last_rec_at = "sync";
      FRESULT rec = recover_file();
      if (rec != FR_OK) return handle_error(rec, "sync");
    } else {
      had_clean_sync = 1;
    }
  }

  // File rotation
  if (f_tell(&log_file_obj) + io_pos >= MAX_FILE_SIZE) {
    FRESULT res = flush_io_buf();
    if (res != FR_OK) return res;
    f_truncate(&log_file_obj);
    f_close(&log_file_obj);
    res = create_new_log_file();
    if (res != FR_OK) {
      return handle_error(res, "rotate");
    }
  }

  return FR_OK;
}

FRESULT lw_write_marker(const char* msg) {
  if (error_state || paused) return FR_OK;

  FRESULT res = flush_io_buf();
  if (res != FR_OK) return res;

  uint16_t ts = (uint16_t)(((uint64_t)HAL_GetTick() * 100) & 0xFFFF);
  int ret = mlg_write_marker(write_buf, sizeof(write_buf),
                             block_counter++, ts, msg ? msg : "");
  if (ret < 0) return FR_INT_ERR;

  UINT bw;
  FRESULT wres = f_write(&log_file_obj, write_buf, ret, &bw);
  if (wres == FR_OK) {
    // Visual feedback: toggle LED1 a few times. LED1 is ON during recording,
    // so toggles produce short dark pulses and end back ON (even toggle count).
    marker_blink_remaining = MARKER_BLINK_TOGGLES;
    last_tick_led1 = HAL_GetTick() - MARKER_BLINK_INTERVAL;
  }
  return wres;
}

void lw_stop(void) {
  if (!paused) {
    flush_io_buf();
    f_sync(&log_file_obj);
    f_truncate(&log_file_obj);
    f_close(&log_file_obj);
  }
  f_mount(0, "", 0);
  set_led(LED1, LED_OFF);
  set_led(LED2, LED_ON);
}

void lw_pause(void) {
  if (paused || error_state) return;
  flush_io_buf();
  f_sync(&log_file_obj);
  f_truncate(&log_file_obj);
  f_close(&log_file_obj);
  paused = 1;
}

void lw_update_leds(void) {
  if (error_state) {
    toggle_led(LED1, &last_tick_led1, BLINK_INTERVAL_ERROR);
    toggle_led(LED2, &last_tick_led2, BLINK_INTERVAL_ERROR);
  } else {
    toggle_led(LED2, &last_tick_led2, BLINK_INTERVAL_NORMAL);
    if (marker_blink_remaining > 0) {
      uint32_t now = HAL_GetTick();
      if (now - last_tick_led1 >= MARKER_BLINK_INTERVAL) {
        HAL_GPIO_TogglePin(LED_1_GPIO_Port, LED_1_Pin);
        last_tick_led1 = now;
        marker_blink_remaining--;
      }
    }
  }
}

int lw_is_error(void) {
  return error_state;
}

void lw_get_status(lw_Status* out) {
  out->file_name   = log_file_name;
  out->file_size   = (error_state || paused) ? 0 : f_tell(&log_file_obj);
  out->file_count  = file_counter;
  out->error_count = error_count;
  out->error_state = error_state;
  out->last_error = last_error;
  out->last_error_at = last_error_at;
  out->last_rec_res = last_rec_res;
  out->last_rec_at = last_rec_at;
  out->recovery_count = recovery_count;
  out->block_count = block_counter;

  sd_ErrorCounters ec;
  sd_get_error_counters(&ec);
  out->sd_cmd_timeout   = ec.cmd_rsp_timeout;
  out->sd_data_timeout  = ec.data_timeout;
  out->sd_data_crc_fail = ec.data_crc_fail;
  out->sd_dma_error     = ec.dma_error;
  out->sd_err_callbacks = ec.total_callbacks;
  out->sd_last_err_code = ec.last_error_code;
  out->sd_hal_err_code  = ec.hal_error_code;
}

#define RECOVERY_DELAY_MS 1000
#define MAX_RECOVERY_COUNT 20  // cap to detect persistent SD failure

static FRESULT recover_file(void) {
  recovery_count++;
  if (recovery_count >= MAX_RECOVERY_COUNT) {
    return FR_DISK_ERR;  // persistent failure → handle_error → fault state
  }
  // Shrink 32 MB preallocation down to actually-written data before closing.
  // Only attempt if at least one f_sync has succeeded in this file's lifetime
  // — otherwise FAT state is suspect and further SDIO ops may hang. When
  // skipped, the old file stays at full 32 MB with garbage tail, but a clean
  // new file gets created below. Better a corrupt old file than a hung task.
  if (had_clean_sync) {
    f_truncate(&log_file_obj);
    f_sync(&log_file_obj);
  }
  f_close(&log_file_obj);
  // Remount SD — card may need full re-init after GC stall
  f_mount(0, "", 0);
  osDelay(RECOVERY_DELAY_MS);
  FRESULT res = f_mount(&SDFatFS, (TCHAR const *)SDPath, 1);
  if (res != FR_OK) return res;
  res = create_new_log_file();
  if (res == FR_OK) {
    error_count = 0;
  }
  return res;
}

static FRESULT flush_io_buf(void) {
  if (io_pos == 0) return FR_OK;
  UINT bw;
  FRESULT res = f_write(&log_file_obj, io_buf, io_pos, &bw);
  if (res == FR_OK) {
    io_pos = 0;
    return FR_OK;
  }
  // Write failed — file object may be invalid, try recovery
  uint16_t saved_pos = io_pos;
  io_pos = 0;  // clear before recovery (create_new_log_file writes header)
  last_rec_res = res;
  last_rec_at = "write";
  res = recover_file();
  if (res != FR_OK) return handle_error(res, "recovery");
  // Retry writing the lost buffer into the new file
  res = f_write(&log_file_obj, io_buf, saved_pos, &bw);
  if (res != FR_OK) return handle_error(res, "write");
  return FR_OK;
}

static FRESULT create_new_log_file(void) {
  DateTime dt;
  get_current_datetime(&dt);

  // Try unique filename: ..._00.mlg, ..._01.mlg, ... (suffix increments on collision)
  for (int suffix = 0; suffix < 100; suffix++) {
    snprintf(log_file_name, sizeof(log_file_name),
             "20%02d-%02d-%02d_%02d-%02d-%02d_%02d.mlg",
             dt.year % 100, dt.month, dt.day,
             dt.hour, dt.minute, dt.second, suffix);

    FRESULT res = f_open(&log_file_obj, log_file_name, FA_CREATE_NEW | FA_WRITE);
    if (res == FR_OK) goto file_created;
    if (res != FR_EXIST) return handle_error(res, "create");
  }
  return handle_error(FR_EXIST, "create");

file_created:
  file_counter++;

  // Pre-allocate contiguous space (opt=1) — same as rusEFI mmc_card.cpp.
  // Avoids FAT-table reads/writes interleaved with data stream, which
  // caused CMD_RSP_TIMEOUT when card was still in PROGRAMMING state.
  f_expand(&log_file_obj, MAX_FILE_SIZE, 1);
  f_lseek(&log_file_obj, 0);

  FRESULT res = write_mlg_file_header();
  if (res != FR_OK) {
    f_close(&log_file_obj);
    return handle_error(res, "header");
  }

  block_counter = 0;
  had_clean_sync = 0;  // fresh file — no clean sync yet
  return FR_OK;
}

static uint32_t datetime_to_unix(const DateTime* dt) {
  // Days from 1970-01-01 to 2000-01-01 = 10957
  uint32_t year = dt->year + 2000;
  uint32_t days = (year - 1970) * 365 + ((year - 1969) / 4);
  static const uint16_t mdays[] = {0, 31, 59, 90, 120, 151, 181, 212, 243, 273, 304, 334};
  if (dt->month >= 1 && dt->month <= 12) {
    days += mdays[dt->month - 1];
  }
  // Leap year correction for current year
  if (dt->month > 2 && (year % 4 == 0)) days++;
  days += dt->day - 1;
  return days * 86400 + dt->hour * 3600 + dt->minute * 60 + dt->second;
}

static void get_current_datetime(DateTime* dt) {
  RTC_DateTypeDef d;
  RTC_TimeTypeDef t;
  HAL_RTC_GetTime(&hrtc, &t, RTC_FORMAT_BCD);
  HAL_RTC_GetDate(&hrtc, &d, RTC_FORMAT_BCD);
  dt->year   = (d.Year >> 4) * 10 + (d.Year & 0x0F);
  dt->month  = (d.Month >> 4) * 10 + (d.Month & 0x0F);
  dt->day    = (d.Date >> 4) * 10 + (d.Date & 0x0F);
  dt->hour   = (t.Hours >> 4) * 10 + (t.Hours & 0x0F);
  dt->minute = (t.Minutes >> 4) * 10 + (t.Minutes & 0x0F);
  dt->second = (t.Seconds >> 4) * 10 + (t.Seconds & 0x0F);
}

static void set_led(int led, int state) {
  GPIO_PinState ps = (state == LED_ON) ? GPIO_PIN_RESET : GPIO_PIN_SET;
  if (led == LED1) HAL_GPIO_WritePin(LED_1_GPIO_Port, LED_1_Pin, ps);
  else if (led == LED2) HAL_GPIO_WritePin(LED_2_GPIO_Port, LED_2_Pin, ps);
}

static void toggle_led(int led, uint32_t* last_tick, uint32_t interval) {
  if (HAL_GetTick() - *last_tick >= interval) {
    if (led == LED1) HAL_GPIO_TogglePin(LED_1_GPIO_Port, LED_1_Pin);
    else if (led == LED2) HAL_GPIO_TogglePin(LED_2_GPIO_Port, LED_2_Pin);
    *last_tick = HAL_GetTick();
  }
}

static uint32_t fault_counter = 0;

static void write_fault_file(FRESULT fault_res, const char* fault_at) {
  f_close(&log_file_obj);
  f_mount(0, "", 0);
  osDelay(500);
  FRESULT res = f_mount(&SDFatFS, (TCHAR const *)SDPath, 1);
  if (res != FR_OK) return;

  char fname[13];
  snprintf(fname, sizeof(fname), "FAULT_%02lu.TXT",
           (unsigned long)(fault_counter++ % 100));

  FIL fault_file;
  res = f_open(&fault_file, fname, FA_CREATE_ALWAYS | FA_WRITE);
  if (res != FR_OK) return;

  sd_ErrorCounters ec;
  sd_get_error_counters(&ec);

  DateTime dt;
  get_current_datetime(&dt);
  uint32_t uptime = HAL_GetTick();

  int len = snprintf((char*)io_buf, IO_BUF_SIZE,
    "=== CANLOGGER FAULT REPORT ===\r\n"
    "Time: 20%02u-%02u-%02u %02u:%02u:%02u\r\n"
    "Uptime: %lu ms (%lu s)\r\n"
    "\r\n"
    "--- Fault Info ---\r\n"
    "FatFS error: FR_%d\r\n"
    "Location: %s\r\n"
    "Error count: %d (max %d)\r\n"
    "Recovery count: %lu\r\n"
    "File: %s\r\n"
    "Files created: %lu\r\n"
    "\r\n"
    "--- SD/SDIO Error Counters ---\r\n"
    "Total callbacks: %lu\r\n"
    "CMD_RSP_TIMEOUT: %lu\r\n"
    "CMD_CRC_FAIL:    %lu\r\n"
    "DATA_TIMEOUT:    %lu\r\n"
    "DATA_CRC_FAIL:   %lu\r\n"
    "TX_UNDERRUN:     %lu\r\n"
    "DMA_ERROR:       %lu\r\n"
    "Other:           %lu\r\n"
    "Last ErrorCode:  0x%08lX\r\n"
    "HAL ErrorCode:   0x%08lX\r\n"
    "\r\n"
    "=== END FAULT REPORT ===\r\n",
    dt.year, dt.month, dt.day, dt.hour, dt.minute, dt.second,
    (unsigned long)uptime, (unsigned long)(uptime / 1000),
    (int)fault_res, fault_at,
    error_count, MAX_ERROR_COUNT,
    (unsigned long)recovery_count,
    log_file_name, (unsigned long)file_counter,
    (unsigned long)ec.total_callbacks,
    (unsigned long)ec.cmd_rsp_timeout,
    (unsigned long)ec.cmd_crc_fail,
    (unsigned long)ec.data_timeout,
    (unsigned long)ec.data_crc_fail,
    (unsigned long)ec.tx_underrun,
    (unsigned long)ec.dma_error,
    (unsigned long)ec.other_error,
    (unsigned long)ec.last_error_code,
    (unsigned long)ec.hal_error_code);

  if (len > 0) {
    UINT bw;
    f_write(&fault_file, io_buf, (UINT)len, &bw);
  }
  f_close(&fault_file);
}

void lw_write_test_fault(void) {
  set_error_state(FR_INT_ERR, "test");
}

static void set_error_state(FRESULT res, const char* at) {
  error_state = 1;
  last_error = res;
  last_error_at = at;
  bkp_log_fault((uint8_t)res, bkp_at_from_name(at));  // persistent — survives reset/power loss
  write_fault_file(res, at);                          // may fail if SD not mountable
}

static FRESULT handle_error(FRESULT res, const char* at) {
  error_count++;
  last_error = res;
  last_error_at = at;
  if (error_count >= MAX_ERROR_COUNT) set_error_state(res, at);
  return res;
}
