irudoy/canlogger/firmware/Src/sd_diskio.c

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

/* Note: code generation based on sd_diskio_dma_rtos_template_bspv1.c v2.1.4
   as FreeRTOS is enabled. */

/* USER CODE BEGIN firstSection */
/* can be used to modify / undefine following code or add new definitions */
#include "cmsis_os2.h"
#include "sd_diskio_counters.h"
static sd_sdio_Counters g_sd_sdio_counters;
void sd_sdio_get_counters(sd_sdio_Counters* out) {
  *out = g_sd_sdio_counters;
}
/* USER CODE END firstSection*/

/* Includes ------------------------------------------------------------------*/
#include "ff_gen_drv.h"
#include "sd_diskio.h"

#include <string.h>
#include <stdio.h>


#define QUEUE_SIZE         (uint32_t) 10
#define READ_CPLT_MSG      (uint32_t) 1
#define WRITE_CPLT_MSG     (uint32_t) 2
/*
==================================================================
enable the defines below to send custom rtos messages
when an error or an abort occurs.
Notice: depending on the HAL/SD driver the HAL_SD_ErrorCallback()
may not be available.
See BSP_SD_ErrorCallback() and BSP_SD_AbortCallback() below
==================================================================

#define RW_ERROR_MSG       (uint32_t) 3
#define RW_ABORT_MSG       (uint32_t) 4
*/
/*
 * the following Timeout is useful to give the control back to the applications
 * in case of errors in either BSP_SD_ReadCpltCallback() or BSP_SD_WriteCpltCallback()
 * the value by default is as defined in the BSP platform driver otherwise 30 secs
 */
#define SD_TIMEOUT 30 * 1000

#define SD_DEFAULT_BLOCK_SIZE 512

/*
 * Depending on the use case, the SD card initialization could be done at the
 * application level: if it is the case define the flag below to disable
 * the BSP_SD_Init() call in the SD_Initialize() and add a call to
 * BSP_SD_Init() elsewhere in the application.
 */
/* USER CODE BEGIN disableSDInit */
/* #define DISABLE_SD_INIT */
/* USER CODE END disableSDInit */

/*
 * when using cacheable memory region, it may be needed to maintain the cache
 * validity. Enable the define below to activate a cache maintenance at each
 * read and write operation.
 * Notice: This is applicable only for cortex M7 based platform.
 */
/* USER CODE BEGIN enableSDDmaCacheMaintenance */
/* #define ENABLE_SD_DMA_CACHE_MAINTENANCE  1 */
/* USER CODE END enableSDDmaCacheMaintenance */

/*
* Some DMA requires 4-Byte aligned address buffer to correctly read/write data,
* in FatFs some accesses aren't thus we need a 4-byte aligned scratch buffer to correctly
* transfer data
*/
/* USER CODE BEGIN enableScratchBuffer */
#define ENABLE_SCRATCH_BUFFER
/* USER CODE END enableScratchBuffer */

#if defined(ENABLE_SCRATCH_BUFFER)
#if defined (ENABLE_SD_DMA_CACHE_MAINTENANCE)
ALIGN_32BYTES(static uint8_t scratch[BLOCKSIZE]); // 32-Byte aligned for cache maintenance
#else
__ALIGN_BEGIN static uint8_t scratch[BLOCKSIZE] __ALIGN_END;
#endif
#endif
/* Disk status */
static volatile DSTATUS Stat = STA_NOINIT;

#if (osCMSIS <= 0x20000U)
static osMessageQId SDQueueID = NULL;
#else
static osMessageQueueId_t SDQueueID = NULL;
#endif
static DSTATUS SD_CheckStatus(BYTE lun);
DSTATUS SD_initialize (BYTE);
DSTATUS SD_status (BYTE);
DRESULT SD_read (BYTE, BYTE*, DWORD, UINT);
#if _USE_WRITE == 1
DRESULT SD_write (BYTE, const BYTE*, DWORD, UINT);
#endif /* _USE_WRITE == 1 */
#if _USE_IOCTL == 1
DRESULT SD_ioctl (BYTE, BYTE, void*);
#endif  /* _USE_IOCTL == 1 */

const Diskio_drvTypeDef  SD_Driver =
{
  SD_initialize,
  SD_status,
  SD_read,
#if  _USE_WRITE == 1
  SD_write,
#endif /* _USE_WRITE == 1 */

#if  _USE_IOCTL == 1
  SD_ioctl,
#endif /* _USE_IOCTL == 1 */
};

/* USER CODE BEGIN beforeFunctionSection */
/* Rename SD_status so we can instrument it in lastSection.
 * SD_status is called by FatFS validate() on every f_sync/f_write/etc.
 * A transient CMD13 failure here makes validate return FR_INVALID_OBJECT
 * without any SD_write being issued — prime suspect for f_sync failures.
 * NOTE: must be done here (before SD_status definition), NOT in
 * beforeReadSection which comes after the definition. */
#define SD_status SD_status_deprecated
DSTATUS SD_status(BYTE);  /* expands to SD_status_deprecated, silences -Wmissing-declarations */
/* USER CODE END beforeFunctionSection */


static int SD_CheckStatusWithTimeout(uint32_t timeout)
{
  uint32_t timer;
  /* block until SDIO peripheral is ready again or a timeout occur */
#if (osCMSIS <= 0x20000U)
  timer = osKernelSysTick();
  while( osKernelSysTick() - timer < timeout)
#else
  timer = osKernelGetTickCount();
  while( osKernelGetTickCount() - timer < timeout)
#endif
  {
    if (BSP_SD_GetCardState() == SD_TRANSFER_OK)
    {
      return 0;
    }
  }

  return -1;
}

static DSTATUS SD_CheckStatus(BYTE lun)
{
  Stat = STA_NOINIT;

  if(BSP_SD_GetCardState() == SD_TRANSFER_OK)
  {
    Stat &= ~STA_NOINIT;
  }

  return Stat;
}

/**
  * @brief  Initializes a Drive
  * @param  lun : not used
  * @retval DSTATUS: Operation status
  */
DSTATUS SD_initialize(BYTE lun)
{
Stat = STA_NOINIT;

  /*
   * check that the kernel has been started before continuing
   * as the osMessage API will fail otherwise
   */
#if (osCMSIS <= 0x20000U)
  if(osKernelRunning())
#else
  if(osKernelGetState() == osKernelRunning)
#endif
  {
#if !defined(DISABLE_SD_INIT)

    if(BSP_SD_Init() == MSD_OK)
    {
      Stat = SD_CheckStatus(lun);
    }

#else
    Stat = SD_CheckStatus(lun);
#endif

    /*
    * if the SD is correctly initialized, create the operation queue
    * if not already created
    */

    if (Stat != STA_NOINIT)
    {
      if (SDQueueID == NULL)
      {
 #if (osCMSIS <= 0x20000U)
      osMessageQDef(SD_Queue, QUEUE_SIZE, uint16_t);
      SDQueueID = osMessageCreate (osMessageQ(SD_Queue), NULL);
#else
      SDQueueID = osMessageQueueNew(QUEUE_SIZE, 2, NULL);
#endif
      }

      if (SDQueueID == NULL)
      {
        Stat |= STA_NOINIT;
      }
    }
  }

  return Stat;
}

/**
  * @brief  Gets Disk Status
  * @param  lun : not used
  * @retval DSTATUS: Operation status
  */
DSTATUS SD_status(BYTE lun)
{
  return SD_CheckStatus(lun);
}

/* USER CODE BEGIN beforeReadSection */
/* can be used to modify previous code / undefine following code / add new code */
/* USER CODE END beforeReadSection */
/**
  * @brief  Reads Sector(s)
  * @param  lun : not used
  * @param  *buff: Data buffer to store read data
  * @param  sector: Sector address (LBA)
  * @param  count: Number of sectors to read (1..128)
  * @retval DRESULT: Operation result
  */

DRESULT SD_read(BYTE lun, BYTE *buff, DWORD sector, UINT count)
{
  uint8_t ret;
  DRESULT res = RES_ERROR;
  uint32_t timer;
#if (osCMSIS < 0x20000U)
  osEvent event;
#else
  uint16_t event;
  osStatus_t status;
#endif
#if (ENABLE_SD_DMA_CACHE_MAINTENANCE == 1)
  uint32_t alignedAddr;
#endif
  /*
  * ensure the SDCard is ready for a new operation
  */

  if (SD_CheckStatusWithTimeout(SD_TIMEOUT) < 0)
  {
    return res;
  }

#if defined(ENABLE_SCRATCH_BUFFER)
  if (!((uint32_t)buff & 0x3))
  {
#endif
    /* Fast path cause destination buffer is correctly aligned */
    ret = BSP_SD_ReadBlocks_DMA((uint32_t*)buff, (uint32_t)(sector), count);

    if (ret == MSD_OK) {
#if (osCMSIS < 0x20000U)
    /* wait for a message from the queue or a timeout */
    event = osMessageGet(SDQueueID, SD_TIMEOUT);

    if (event.status == osEventMessage)
    {
      if (event.value.v == READ_CPLT_MSG)
      {
        timer = osKernelSysTick();
        /* block until SDIO IP is ready or a timeout occur */
        while(osKernelSysTick() - timer <SD_TIMEOUT)
#else
          status = osMessageQueueGet(SDQueueID, (void *)&event, NULL, SD_TIMEOUT);
          if ((status == osOK) && (event == READ_CPLT_MSG))
          {
            timer = osKernelGetTickCount();
            /* block until SDIO IP is ready or a timeout occur */
            while(osKernelGetTickCount() - timer <SD_TIMEOUT)
#endif
            {
              if (BSP_SD_GetCardState() == SD_TRANSFER_OK)
              {
                res = RES_OK;
#if (ENABLE_SD_DMA_CACHE_MAINTENANCE == 1)
                /*
                the SCB_InvalidateDCache_by_Addr() requires a 32-Byte aligned address,
                adjust the address and the D-Cache size to invalidate accordingly.
                */
                alignedAddr = (uint32_t)buff & ~0x1F;
                SCB_InvalidateDCache_by_Addr((uint32_t*)alignedAddr, count*BLOCKSIZE + ((uint32_t)buff - alignedAddr));
#endif
                break;
              }
            }
#if (osCMSIS < 0x20000U)
          }
        }
#else
      }
#endif
    }

#if defined(ENABLE_SCRATCH_BUFFER)
    }
    else
    {
      /* Slow path, fetch each sector a part and memcpy to destination buffer */
      int i;

      for (i = 0; i < count; i++)
      {
        ret = BSP_SD_ReadBlocks_DMA((uint32_t*)scratch, (uint32_t)sector++, 1);
        if (ret == MSD_OK )
        {
          /* wait until the read is successful or a timeout occurs */
#if (osCMSIS < 0x20000U)
          /* wait for a message from the queue or a timeout */
          event = osMessageGet(SDQueueID, SD_TIMEOUT);

          if (event.status == osEventMessage)
          {
            if (event.value.v == READ_CPLT_MSG)
            {
              timer = osKernelSysTick();
              /* block until SDIO IP is ready or a timeout occur */
              while(osKernelSysTick() - timer <SD_TIMEOUT)
#else
                status = osMessageQueueGet(SDQueueID, (void *)&event, NULL, SD_TIMEOUT);
              if ((status == osOK) && (event == READ_CPLT_MSG))
              {
                timer = osKernelGetTickCount();
                /* block until SDIO IP is ready or a timeout occur */
                ret = MSD_ERROR;
                while(osKernelGetTickCount() - timer < SD_TIMEOUT)
#endif
                {
                  ret = BSP_SD_GetCardState();

                  if (ret == MSD_OK)
                  {
                    break;
                  }
                }

                if (ret != MSD_OK)
                {
                  break;
                }
#if (osCMSIS < 0x20000U)
              }
            }
#else
          }
#endif
#if (ENABLE_SD_DMA_CACHE_MAINTENANCE == 1)
          /*
          *
          * invalidate the scratch buffer before the next read to get the actual data instead of the cached one
          */
          SCB_InvalidateDCache_by_Addr((uint32_t*)scratch, BLOCKSIZE);
#endif
          memcpy(buff, scratch, BLOCKSIZE);
          buff += BLOCKSIZE;
        }
        else
        {
          break;
        }
      }

      if ((i == count) && (ret == MSD_OK ))
        res = RES_OK;
    }
#endif
  return res;
}

/* USER CODE BEGIN beforeWriteSection */
/* Rename the CubeMX-generated SD_write so we can install an instrumented
 * replacement in lastSection. The renamed function becomes dead code (DCE),
 * and the SD_Driver struct above (which was emitted before this #define)
 * still references SD_write — which, thanks to the #undef in lastSection,
 * resolves to our new instrumented version.
 * Rationale: SD_write body is outside USER CODE markers and cannot be edited
 * directly. This trick keeps CubeMX regeneration safe. */
#define SD_write SD_write_deprecated
/* Forward prototype for the renamed stock function (silences
 * -Wmissing-declarations on its definition below). */
DRESULT SD_write(BYTE, const BYTE*, DWORD, UINT);
/* USER CODE END beforeWriteSection */
/**
  * @brief  Writes Sector(s)
  * @param  lun : not used
  * @param  *buff: Data to be written
  * @param  sector: Sector address (LBA)
  * @param  count: Number of sectors to write (1..128)
  * @retval DRESULT: Operation result
  */
#if _USE_WRITE == 1

DRESULT SD_write(BYTE lun, const BYTE *buff, DWORD sector, UINT count)
{
  DRESULT res = RES_ERROR;
  uint32_t timer;

#if (osCMSIS < 0x20000U)
  osEvent event;
#else
  uint16_t event;
  osStatus_t status;
#endif

#if defined(ENABLE_SCRATCH_BUFFER)
  int32_t ret;
#endif

  /*
  * ensure the SDCard is ready for a new operation
  */

  if (SD_CheckStatusWithTimeout(SD_TIMEOUT) < 0)
  {
    return res;
  }

#if defined(ENABLE_SCRATCH_BUFFER)
  if (!((uint32_t)buff & 0x3))
  {
#endif
#if (ENABLE_SD_DMA_CACHE_MAINTENANCE == 1)
  uint32_t alignedAddr;
  /*
    the SCB_CleanDCache_by_Addr() requires a 32-Byte aligned address
    adjust the address and the D-Cache size to clean accordingly.
  */
  alignedAddr = (uint32_t)buff & ~0x1F;
  SCB_CleanDCache_by_Addr((uint32_t*)alignedAddr, count*BLOCKSIZE + ((uint32_t)buff - alignedAddr));
#endif

  if(BSP_SD_WriteBlocks_DMA((uint32_t*)buff,
                           (uint32_t) (sector),
                           count) == MSD_OK)
  {
#if (osCMSIS < 0x20000U)
    /* Get the message from the queue */
    event = osMessageGet(SDQueueID, SD_TIMEOUT);

    if (event.status == osEventMessage)
    {
      if (event.value.v == WRITE_CPLT_MSG)
      {
#else
    status = osMessageQueueGet(SDQueueID, (void *)&event, NULL, SD_TIMEOUT);
    if ((status == osOK) && (event == WRITE_CPLT_MSG))
    {
#endif
 #if (osCMSIS < 0x20000U)
        timer = osKernelSysTick();
        /* block until SDIO IP is ready or a timeout occur */
        while(osKernelSysTick() - timer  < SD_TIMEOUT)
#else
        timer = osKernelGetTickCount();
        /* block until SDIO IP is ready or a timeout occur */
        while(osKernelGetTickCount() - timer  < SD_TIMEOUT)
#endif
        {
          if (BSP_SD_GetCardState() == SD_TRANSFER_OK)
          {
            res = RES_OK;
            break;
          }
        }
#if (osCMSIS < 0x20000U)
      }
    }
#else
    }
#endif
  }
#if defined(ENABLE_SCRATCH_BUFFER)
  }
  else {
    /* Slow path, fetch each sector a part and memcpy to destination buffer */
    int i;

#if (ENABLE_SD_DMA_CACHE_MAINTENANCE == 1)
    /*
     * invalidate the scratch buffer before the next write to get the actual data instead of the cached one
     */
     SCB_InvalidateDCache_by_Addr((uint32_t*)scratch, BLOCKSIZE);
#endif
      for (i = 0; i < count; i++)
      {
        memcpy((void *)scratch, buff, BLOCKSIZE);
        buff += BLOCKSIZE;

        ret = BSP_SD_WriteBlocks_DMA((uint32_t*)scratch, (uint32_t)sector++, 1);
        if (ret == MSD_OK )
        {
          /* wait until the read is successful or a timeout occurs */
#if (osCMSIS < 0x20000U)
          /* wait for a message from the queue or a timeout */
          event = osMessageGet(SDQueueID, SD_TIMEOUT);

          if (event.status == osEventMessage)
          {
            if (event.value.v == READ_CPLT_MSG)
            {
              timer = osKernelSysTick();
              /* block until SDIO IP is ready or a timeout occur */
              while(osKernelSysTick() - timer <SD_TIMEOUT)
#else
                status = osMessageQueueGet(SDQueueID, (void *)&event, NULL, SD_TIMEOUT);
              if ((status == osOK) && (event == READ_CPLT_MSG))
              {
                timer = osKernelGetTickCount();
                /* block until SDIO IP is ready or a timeout occur */
                ret = MSD_ERROR;
                while(osKernelGetTickCount() - timer < SD_TIMEOUT)
#endif
                {
                  ret = BSP_SD_GetCardState();

                  if (ret == MSD_OK)
                  {
                    break;
                  }
                }

                if (ret != MSD_OK)
                {
                  break;
                }
#if (osCMSIS < 0x20000U)
              }
            }
#else
          }
#endif
        }
        else
        {
          break;
        }
      }

      if ((i == count) && (ret == MSD_OK ))
        res = RES_OK;
    }

#endif

  return res;
}
 #endif /* _USE_WRITE == 1 */

/* USER CODE BEGIN beforeIoctlSection */
/* can be used to modify previous code / undefine following code / add new code */
/* USER CODE END beforeIoctlSection */
/**
  * @brief  I/O control operation
  * @param  lun : not used
  * @param  cmd: Control code
  * @param  *buff: Buffer to send/receive control data
  * @retval DRESULT: Operation result
  */
#if _USE_IOCTL == 1
DRESULT SD_ioctl(BYTE lun, BYTE cmd, void *buff)
{
  DRESULT res = RES_ERROR;
  BSP_SD_CardInfo CardInfo;

  if (Stat & STA_NOINIT) return RES_NOTRDY;

  switch (cmd)
  {
  /* Make sure that no pending write process */
  case CTRL_SYNC :
    res = RES_OK;
    break;

  /* Get number of sectors on the disk (DWORD) */
  case GET_SECTOR_COUNT :
    BSP_SD_GetCardInfo(&CardInfo);
    *(DWORD*)buff = CardInfo.LogBlockNbr;
    res = RES_OK;
    break;

  /* Get R/W sector size (WORD) */
  case GET_SECTOR_SIZE :
    BSP_SD_GetCardInfo(&CardInfo);
    *(WORD*)buff = CardInfo.LogBlockSize;
    res = RES_OK;
    break;

  /* Get erase block size in unit of sector (DWORD) */
  case GET_BLOCK_SIZE :
    BSP_SD_GetCardInfo(&CardInfo);
    *(DWORD*)buff = CardInfo.LogBlockSize / SD_DEFAULT_BLOCK_SIZE;
    res = RES_OK;
    break;

  default:
    res = RES_PARERR;
  }

  return res;
}
#endif /* _USE_IOCTL == 1 */

/* USER CODE BEGIN afterIoctlSection */
/* can be used to modify previous code / undefine following code / add new code */
/* USER CODE END afterIoctlSection */

/* USER CODE BEGIN callbackSection */
/* can be used to modify / following code or add new code */
/* USER CODE END callbackSection */
/**
  * @brief Tx Transfer completed callbacks
  * @param hsd: SD handle
  * @retval None
  */
void BSP_SD_WriteCpltCallback(void)
{

  /*
   * No need to add an "osKernelRunning()" check here, as the SD_initialize()
   * is always called before any SD_Read()/SD_Write() call
   */
#if (osCMSIS < 0x20000U)
   osMessagePut(SDQueueID, WRITE_CPLT_MSG, 0);
#else
   const uint16_t msg = WRITE_CPLT_MSG;
   osMessageQueuePut(SDQueueID, (const void *)&msg, 0, 0);
#endif
}

/**
  * @brief Rx Transfer completed callbacks
  * @param hsd: SD handle
  * @retval None
  */
void BSP_SD_ReadCpltCallback(void)
{
  /*
   * No need to add an "osKernelRunning()" check here, as the SD_initialize()
   * is always called before any SD_Read()/SD_Write() call
   */
#if (osCMSIS < 0x20000U)
   osMessagePut(SDQueueID, READ_CPLT_MSG, 0);
#else
   const uint16_t msg = READ_CPLT_MSG;
   osMessageQueuePut(SDQueueID, (const void *)&msg, 0, 0);
#endif
}

/* USER CODE BEGIN ErrorAbortCallbacks */
/*
==============================================================================================
  depending on the SD_HAL_Driver version, either the HAL_SD_ErrorCallback() or HAL_SD_AbortCallback()
  or both could be defined, activate the callbacks below when suitable and needed
==============================================================================================
void BSP_SD_AbortCallback(void)
{
}

void BSP_SD_ErrorCallback(void)
{
}
*/
/* USER CODE END ErrorAbortCallbacks */

/* USER CODE BEGIN lastSection */
extern SD_HandleTypeDef hsd;  /* defined in main.c */

/* Max time SD_status will wait for the card to leave a transient
 * PROGRAMMING/RECEIVING state before declaring the disk not-ready.
 * FatFS validate() calls SD_status on every f_sync/f_write; without
 * the retry loop, transient PROGRAMMING (the card's own background GC
 * after a prior write) makes validate() return FR_INVALID_OBJECT even
 * though no disk I/O was attempted. 100 ms is well above the typical
 * GC stall (a few ms) yet small enough not to wreck main-loop
 * responsiveness on the rare hard failure. */
#define SD_STATUS_RETRY_MS 100u

/* Instrumented, retry-capable replacement for SD_status. Called by FatFS
 * validate() on every file operation (f_sync/f_write/f_tell/...). */
#undef SD_status
DSTATUS SD_status(BYTE lun)
{
  (void)lun;
  g_sd_sdio_counters.status_calls++;

  /* Fast path: card already in TRANSFER state. */
  if (BSP_SD_GetCardState() == MSD_OK) {
    Stat &= ~STA_NOINIT;
    return Stat;
  }

  /* Slow path: give the card up to SD_STATUS_RETRY_MS to leave
   * PROGRAMMING. osDelay(1) yields the current FreeRTOS task for 1 tick,
   * letting higher-priority tasks (CAN drain, demo gen) continue while
   * the SD card finishes its GC stall. This is the key decoupling point. */
  g_sd_sdio_counters.status_fail_not_ready++;
  uint32_t t0 = HAL_GetTick();
  while ((HAL_GetTick() - t0) < SD_STATUS_RETRY_MS) {
    osDelay(1);
    if (BSP_SD_GetCardState() == MSD_OK) {
      uint32_t dt = HAL_GetTick() - t0;
      g_sd_sdio_counters.status_retry_rescued++;
      if (dt > g_sd_sdio_counters.status_max_retry_ms) {
        g_sd_sdio_counters.status_max_retry_ms = dt;
      }
      Stat &= ~STA_NOINIT;
      return Stat;
    }
  }

  /* Retry exhausted — treat as a real failure. */
  Stat = STA_NOINIT;
  g_sd_sdio_counters.status_hard_fail++;
  g_sd_sdio_counters.last_card_state_raw = (uint32_t)HAL_SD_GetCardState(&hsd);
  return Stat;
}

/* Instrumented replacement for SD_write. Uses the RTOS osMessageQueue
 * for DMA completion (SDQueueID, populated by BSP_SD_WriteCpltCallback)
 * instead of the bare-metal WriteStatus polling. This lets the task yield
 * while waiting for DMA and card GC to finish. */
#undef SD_write
DRESULT SD_write(BYTE lun, const BYTE *buff, DWORD sector, UINT count)
{
  DRESULT res = RES_ERROR;
  uint32_t timeout;
  uint32_t t_start = HAL_GetTick();
  uint8_t ret = 0;
  int i;
  uint16_t event;
  osStatus_t status;

  g_sd_sdio_counters.total_writes++;

  if (SD_CheckStatusWithTimeout(SD_TIMEOUT) < 0)
  {
    g_sd_sdio_counters.err_enter_busy++;
    g_sd_sdio_counters.last_err_sector = sector;
    g_sd_sdio_counters.last_err_count = count;
    g_sd_sdio_counters.last_err_tick = t_start;
    goto out;
  }

  if (!((uint32_t)buff & 0x3))
  {
    /* Fast path: DMA directly from caller buffer. */
    if (BSP_SD_WriteBlocks_DMA((uint32_t*)buff,
                               (uint32_t)sector,
                               count) == MSD_OK)
    {
      /* Wait for DMA Tx complete via RTOS message queue (yields task). */
      status = osMessageQueueGet(SDQueueID, (void *)&event, NULL, SD_TIMEOUT);
      if ((status != osOK) || (event != WRITE_CPLT_MSG))
      {
        g_sd_sdio_counters.err_tx_cplt_timeout++;
        g_sd_sdio_counters.last_err_sector = sector;
        g_sd_sdio_counters.last_err_count = count;
        g_sd_sdio_counters.last_err_tick = t_start;
        goto out;
      }
      /* Wait for card to return to TRANSFER state.
       * osDelay(1) yields to higher-priority tasks during GC stalls. */
      timeout = HAL_GetTick();
      while ((HAL_GetTick() - timeout) < SD_TIMEOUT)
      {
        if (BSP_SD_GetCardState() == SD_TRANSFER_OK)
        {
          res = RES_OK;
          break;
        }
        osDelay(1);
      }
      if (res != RES_OK)
      {
        g_sd_sdio_counters.err_cardstate_timeout++;
        g_sd_sdio_counters.last_err_sector = sector;
        g_sd_sdio_counters.last_err_count = count;
        g_sd_sdio_counters.last_err_tick = t_start;
      }
    }
    else
    {
      g_sd_sdio_counters.err_dma_start++;
      g_sd_sdio_counters.last_err_sector = sector;
      g_sd_sdio_counters.last_err_count = count;
      g_sd_sdio_counters.last_err_tick = t_start;
    }
  }
  else
  {
    /* Slow path: memcpy into scratch buffer, 1 sector at a time. */
    g_sd_sdio_counters.used_scratch_path++;
    for (i = 0; i < (int)count; i++)
    {
      memcpy((void*)scratch, (const void*)buff, BLOCKSIZE);
      buff += BLOCKSIZE;

      ret = BSP_SD_WriteBlocks_DMA((uint32_t*)scratch,
                                   (uint32_t)sector++, 1);
      if (ret == MSD_OK)
      {
        status = osMessageQueueGet(SDQueueID, (void *)&event, NULL, SD_TIMEOUT);
        if ((status != osOK) || (event != WRITE_CPLT_MSG))
        {
          g_sd_sdio_counters.err_slow_tx_cplt++;
          g_sd_sdio_counters.last_err_sector = sector - 1;
          g_sd_sdio_counters.last_err_count = 1;
          g_sd_sdio_counters.last_err_tick = t_start;
          break;
        }
      }
      else
      {
        g_sd_sdio_counters.err_slow_dma_start++;
        g_sd_sdio_counters.last_err_sector = sector - 1;
        g_sd_sdio_counters.last_err_count = 1;
        g_sd_sdio_counters.last_err_tick = t_start;
        break;
      }
    }
    if ((i == (int)count) && (ret == MSD_OK))
    {
      res = RES_OK;
    }
  }

out:
  {
    uint32_t dt = HAL_GetTick() - t_start;
    g_sd_sdio_counters.last_latency_ms = dt;
    if (dt > g_sd_sdio_counters.max_latency_ms)
    {
      g_sd_sdio_counters.max_latency_ms = dt;
    }
  }
  return res;
}
/* USER CODE END lastSection */
