irudoy/canlogger/firmware/Src/can_drv.c

#include "can_drv.h"
#include "main.h"
#include "stm32f4xx_hal.h"

extern CAN_HandleTypeDef hcan1;

static ring_Buffer* rx_ring_buf = NULL;
static volatile uint32_t rx_overrun_count = 0;

// APB1 clock = 42 MHz. Use TQ=21 (BS1=15, BS2=5) for all standard bitrates.
// Prescaler = APB1 / (bitrate * TQ)
static int configure_timing(uint32_t bitrate) {
  uint32_t apb1_freq = 42000000;
  uint32_t tq = 21; // 1 + BS1(15) + BS2(5)

  uint32_t prescaler = apb1_freq / (bitrate * tq);
  if (prescaler == 0 || prescaler > 1024) return -1;

  // Verify exact match
  if (apb1_freq != prescaler * bitrate * tq) return -1;

  HAL_CAN_DeInit(&hcan1);

  hcan1.Instance = CAN1;
  hcan1.Init.Prescaler = prescaler;
  hcan1.Init.Mode = CAN_MODE_NORMAL;
  hcan1.Init.SyncJumpWidth = CAN_SJW_1TQ;
  hcan1.Init.TimeSeg1 = CAN_BS1_15TQ;
  hcan1.Init.TimeSeg2 = CAN_BS2_5TQ;
  hcan1.Init.TimeTriggeredMode = DISABLE;
  hcan1.Init.AutoBusOff = ENABLE;
  hcan1.Init.AutoWakeUp = DISABLE;
  hcan1.Init.AutoRetransmission = DISABLE;
  hcan1.Init.ReceiveFifoLocked = DISABLE;
  hcan1.Init.TransmitFifoPriority = DISABLE;

  if (HAL_CAN_Init(&hcan1) != HAL_OK) return -1;
  return 0;
}

// Configure hardware filters for specific CAN IDs.
// STM32F4 CAN1 has 14 filter banks (0-13).
// If num_ids == 0 or > 14: accept-all filter.
// Otherwise: one filter per ID in ID-list mode.
static int configure_filters(const uint32_t* can_ids, const uint8_t* ext_flags, uint16_t num_ids) {
  CAN_FilterTypeDef filter;

  if (num_ids == 0 || num_ids > 28) {
    // Accept-all: mask mode, all zeros — passes std + ext regardless of flags.
    (void)ext_flags;
    filter.FilterBank = 0;
    filter.FilterMode = CAN_FILTERMODE_IDMASK;
    filter.FilterScale = CAN_FILTERSCALE_32BIT;
    filter.FilterIdHigh = 0x0000;
    filter.FilterIdLow = 0x0000;
    filter.FilterMaskIdHigh = 0x0000;
    filter.FilterMaskIdLow = 0x0000;
    filter.FilterFIFOAssignment = CAN_RX_FIFO0;
    filter.FilterActivation = ENABLE;
    filter.SlaveStartFilterBank = 14;
    return (HAL_CAN_ConfigFilter(&hcan1, &filter) == HAL_OK) ? 0 : -1;
  }

  // ID-list mode: 2 IDs per filter bank (32-bit scale), up to 14 banks = 28 IDs
  for (int i = 0; i < (num_ids + 1) / 2; i++) {
    uint32_t id1 = can_ids[i * 2];
    uint32_t id2 = (i * 2 + 1 < num_ids) ? can_ids[i * 2 + 1] : id1;

    filter.FilterBank = i;
    filter.FilterMode = CAN_FILTERMODE_IDLIST;
    filter.FilterScale = CAN_FILTERSCALE_32BIT;
    // STM32 CAN filter register format (32-bit scale):
    //   StdId: FilterHigh = StdId<<5, FilterLow = 0 (IDE=0)
    //   ExtId: FilterHigh = ExtId>>13, FilterLow = (ExtId<<3)|0x04 (IDE=1)
    uint8_t ext1 = ext_flags[i * 2];
    uint8_t ext2 = (i * 2 + 1 < num_ids) ? ext_flags[i * 2 + 1] : ext1;
    if (ext1) {
      filter.FilterIdHigh = (id1 >> 13) & 0xFFFF;
      filter.FilterIdLow = ((id1 << 3) | 0x04) & 0xFFFF;
    } else {
      filter.FilterIdHigh = (id1 << 5) & 0xFFFF;
      filter.FilterIdLow = 0x0000;
    }
    if (ext2) {
      filter.FilterMaskIdHigh = (id2 >> 13) & 0xFFFF;
      filter.FilterMaskIdLow = ((id2 << 3) | 0x04) & 0xFFFF;
    } else {
      filter.FilterMaskIdHigh = (id2 << 5) & 0xFFFF;
      filter.FilterMaskIdLow = 0x0000;
    }
    filter.FilterFIFOAssignment = CAN_RX_FIFO0;
    filter.FilterActivation = ENABLE;
    filter.SlaveStartFilterBank = 14;

    if (HAL_CAN_ConfigFilter(&hcan1, &filter) != HAL_OK) return -1;
  }

  // Deactivate unused banks
  for (int i = (num_ids + 1) / 2; i < 14; i++) {
    filter.FilterBank = i;
    filter.FilterActivation = DISABLE;
    HAL_CAN_ConfigFilter(&hcan1, &filter);
  }

  return 0;
}

int can_drv_init(ring_Buffer* rb, const cfg_Config* cfg) {
  rx_ring_buf = rb;

  if (configure_timing(cfg->can_bitrate) != 0) return -1;
  if (configure_filters(cfg->can_ids, cfg->can_ids_extended, cfg->num_can_ids) != 0) return -1;

  return 0;
}

int can_drv_start(void) {
  // Ensure NVIC is enabled (may be lost after HAL_CAN_DeInit/Init in configure_timing)
  HAL_NVIC_SetPriority(CAN1_RX0_IRQn, 5, 0);
  HAL_NVIC_EnableIRQ(CAN1_RX0_IRQn);

  if (HAL_CAN_Start(&hcan1) != HAL_OK) return -1;
  if (HAL_CAN_ActivateNotification(&hcan1,
        CAN_IT_RX_FIFO0_MSG_PENDING | CAN_IT_RX_FIFO0_FULL) != HAL_OK) return -1;
  return 0;
}

void can_drv_stop(void) {
  HAL_CAN_DeactivateNotification(&hcan1, CAN_IT_RX_FIFO0_MSG_PENDING);
  HAL_CAN_Stop(&hcan1);
}

// Called by HAL from CAN1_RX0_IRQHandler
void HAL_CAN_RxFifo0MsgPendingCallback(CAN_HandleTypeDef *hcan) {
  if (!rx_ring_buf) return;

  CAN_RxHeaderTypeDef rx_header;
  can_Frame frame;

  if (HAL_CAN_GetRxMessage(hcan, CAN_RX_FIFO0, &rx_header, frame.data) == HAL_OK) {
    frame.id = (rx_header.IDE == CAN_ID_STD) ? rx_header.StdId : rx_header.ExtId;
    frame.dlc = rx_header.DLC;
    ring_buf_push(rx_ring_buf, &frame);
  }
}

// FIFO0 overrun (message lost because FIFO was full)
void HAL_CAN_RxFifo0FullCallback(CAN_HandleTypeDef *hcan) {
  rx_overrun_count++;
}

void can_drv_get_diag(can_Diag* out) {
  uint32_t esr = hcan1.Instance->ESR;
  out->tec = (esr >> 16) & 0xFF;
  out->rec = (esr >> 24) & 0xFF;
  // Bus state from ESR bits [1:0] (BOFF=bit1, EPVF=bit0)
  if (esr & CAN_ESR_BOFF)
    out->bus_state = 2; // Bus-Off
  else if (esr & CAN_ESR_EPVF)
    out->bus_state = 1; // Error Passive
  else
    out->bus_state = 0; // Error Active
  out->lec = (esr >> 4) & 0x07;
  out->rx_overrun = rx_overrun_count;
}
