irudoy/canlogger/firmware/test/config.ini

[logger]
interval_ms = 50
can_bitrate = 500000

# Cansult state notification (0x665)
[field]
can_id = 0x665
name = State
units = raw
start_byte = 0
bit_length = 8
type = U08
scale = 1.0
offset = 0.0
digits = 0
category = Cansult

# CAN ID 0x666: ECU sensors (first 8 registers)
[field]
can_id = 0x666
name = Battery
units = V
start_byte = 0
bit_length = 8
type = U08
scale = 0.08
offset = 0.0
digits = 1
category = Engine

[field]
can_id = 0x666
name = Coolant
units = C
start_byte = 1
bit_length = 8
type = U08
scale = 1.0
offset = -50.0
digits = 0
category = Engine

[field]
can_id = 0x666
name = Ign Timing
units = deg
start_byte = 2
bit_length = 8
type = U08
scale = -1.0
offset = -110.0
digits = 0
category = Engine

[field]
can_id = 0x666
name = O2
units = mV
start_byte = 3
bit_length = 8
type = U08
scale = 10.0
offset = 0.0
digits = 0
category = Engine

[field]
can_id = 0x666
name = TPS
units = mV
start_byte = 4
bit_length = 8
type = U08
scale = 20.0
offset = 0.0
digits = 0
category = Engine

[field]
can_id = 0x666
name = AAC Valve
units = %
start_byte = 5
bit_length = 8
type = U08
scale = 0.5
offset = 0.0
digits = 1
category = Engine

[field]
can_id = 0x666
name = AF Alpha
units = %
start_byte = 6
bit_length = 8
type = U08
scale = 1.0
offset = 0.0
digits = 0
category = Engine

[field]
can_id = 0x666
name = AF Alpha SL
units = %
start_byte = 7
bit_length = 8
type = U08
scale = 1.0
offset = 0.0
digits = 0
category = Engine

# CAN ID 0x667: speed, RPM, injection, MAF
[field]
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
units = %
start_byte = 2
bit_length = 16
type = S16
scale = 0.001
offset = 0.0
is_big_endian = 1
digits = 1
category = AEM UEGO

[field]
can_id = 0x180
is_extended = 1
name = SysVolts
units = V
start_byte = 4
bit_length = 8
type = U08
scale = 0.1
offset = 0.0
digits = 1
category = AEM UEGO
