irudoy/canlogger/firmware/test/demo_stress_128u16.ini

# Hybrid stress: 13 cansult (real CAN @ 500kbit) + 115 demo = 128 fields @ 1kHz
# Tests both real CAN reception and max SD write throughput simultaneously
[logger]
interval_ms=1
can_bitrate=500000
[field]
can_id=0x665
name=State
units=raw
start_byte=0
bit_length=8
type=U08
scale=1
offset=0
digits=0
category=Cansult
[field]
can_id=0x666
name=Battery
units=V
start_byte=0
bit_length=8
type=U08
scale=0.08
offset=0
digits=1
category=Engine
[field]
can_id=0x666
name=Coolant
units=C
start_byte=1
bit_length=8
type=U08
scale=1
offset=-50
digits=0
category=Engine
[field]
can_id=0x666
name=Ign Timing
units=deg
start_byte=2
bit_length=8
type=U08
scale=-1
offset=-110
digits=0
category=Engine
[field]
can_id=0x666
name=O2
units=mV
start_byte=3
bit_length=8
type=U08
scale=10
offset=0
digits=0
category=Engine
[field]
can_id=0x666
name=TPS
units=mV
start_byte=4
bit_length=8
type=U08
scale=20
offset=0
digits=0
category=Engine
[field]
can_id=0x666
name=AAC Valve
units=%
start_byte=5
bit_length=8
type=U08
scale=0.5
offset=0
digits=1
category=Engine
[field]
can_id=0x667
name=Speed
units=km/h
start_byte=0
bit_length=8
type=U08
scale=2
offset=0
digits=0
category=Vehicle
[field]
can_id=0x667
name=RPM
units=rpm
start_byte=1
bit_length=16
type=U16
scale=12.5
offset=0
is_big_endian=1
digits=0
category=Engine
[field]
can_id=0x667
name=Inj Time
units=ms
start_byte=3
bit_length=16
type=U16
scale=0.01
offset=0
is_big_endian=1
digits=2
category=Engine
[field]
can_id=0x667
name=MAF
units=mV
start_byte=5
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
demo_min=0
demo_max=65000
demo_period_ms=7000
[field]
name=S127
units=cnt
type=U16
can_id=0xD1C
start_byte=4
bit_length=16
is_big_endian=1
scale=1
demo_func=ramp
demo_min=0
demo_max=65000
demo_period_ms=3000

# Total: 13 cansult + 115 demo = 128 fields
# Demo CAN IDs: 0xD00..0xD1C (29 IDs)
