irudoy/canlogger/firmware/test/demo_stress_64u16.ini

[logger]
interval_ms=4
can_bitrate=500000
[field]
name=F000
units=V
type=U16
scale=0.01
can_id=0xD00
start_byte=0
bit_length=16
demo_func=noise
demo_min=0.0
demo_max=50.0
demo_smoothing=0.9
[field]
name=F001
units=V
type=U16
scale=0.01
can_id=0xD00
start_byte=2
bit_length=16
demo_func=sine
demo_min=0.5
demo_max=50.7
demo_period_ms=2500
[field]
name=F002
units=V
type=U16
scale=0.01
can_id=0xD00
start_byte=4
bit_length=16
demo_func=ramp
demo_min=1.0
demo_max=51.4
demo_period_ms=3000
[field]
name=F003
units=V
type=U16
scale=0.01
can_id=0xD00
start_byte=6
bit_length=16
demo_func=square
demo_min=1.5
demo_max=52.1
demo_period_ms=3500
[field]
name=F004
units=V
type=U16
scale=0.01
can_id=0xD01
start_byte=0
bit_length=16
demo_func=noise
demo_min=2.0
demo_max=52.8
demo_smoothing=0.9
[field]
name=F005
units=V
type=U16
scale=0.01
can_id=0xD01
start_byte=2
bit_length=16
demo_func=sine
demo_min=2.5
demo_max=53.5
demo_period_ms=4500
[field]
name=F006
units=V
type=U16
scale=0.01
can_id=0xD01
start_byte=4
bit_length=16
demo_func=ramp
demo_min=3.0
demo_max=54.2
demo_period_ms=5000
[field]
name=F007
units=V
type=U16
scale=0.01
can_id=0xD01
start_byte=6
bit_length=16
demo_func=square
demo_min=3.5
demo_max=54.9
demo_period_ms=5500
[field]
name=F008
units=V
type=U16
scale=0.01
can_id=0xD02
start_byte=0
bit_length=16
demo_func=noise
demo_min=4.0
demo_max=55.6
demo_smoothing=0.9
[field]
name=F009
units=V
type=U16
scale=0.01
can_id=0xD02
start_byte=2
bit_length=16
demo_func=sine
demo_min=4.5
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
[field]
name=F058
units=V
type=U16
scale=0.01
can_id=0xD0E
start_byte=4
bit_length=16
demo_func=ramp
demo_min=29.0
demo_max=90.6
demo_period_ms=7000
[field]
name=F059
units=V
type=U16
scale=0.01
can_id=0xD0E
start_byte=6
bit_length=16
demo_func=square
demo_min=29.5
demo_max=91.3
demo_period_ms=7500
[field]
name=F060
units=V
type=U16
scale=0.01
can_id=0xD0F
start_byte=0
bit_length=16
demo_func=noise
demo_min=30.0
demo_max=92.0
demo_smoothing=0.9
[field]
name=F061
units=V
type=U16
scale=0.01
can_id=0xD0F
start_byte=2
bit_length=16
demo_func=sine
demo_min=30.5
demo_max=92.7
demo_period_ms=8500
[field]
name=F062
units=V
type=U16
scale=0.01
can_id=0xD0F
start_byte=4
bit_length=16
demo_func=ramp
demo_min=31.0
demo_max=93.4
demo_period_ms=9000
[field]
name=F063
units=V
type=U16
scale=0.01
can_id=0xD0F
start_byte=6
bit_length=16
demo_func=square
demo_min=31.5
demo_max=94.1
demo_period_ms=9500
