irudoy/canlogger/(commit log)

2026-04-04 feat: add TDD infrastructure, MLVLG encoder, build system, and docs
2026-04-04 feat: enable CAN1, add HARDWARE.md, fix build warnings
    [can_drv.h, canlogger.ioc, log_writer.c, main.c]
2026-04-04 fix: K1 behavior in error state, add OpenOCD debug targets
    [main.c]
2026-04-04 fix: bugs from code review (rounds 1 & 2)
    [can_drv.c, log_writer.c, main.c, test_can_map.c, test_config.c]
2026-04-04 fix: DLC bounds check and config field validation
    [test_can_map.c, test_config.c]
2026-04-04 feat: configurable CAN bitrate and hardware ID filters
2026-04-05 feat: add LUT interpolation for non-linear sensors
2026-04-06 fix: SD compatibility, enable pull-ups on SDIO, add safe shutdown
    [canlogger.ioc, debug_out.c, log_writer.c, log_writer.h]
2026-04-06 perf: buffer SD writes to reduce GC stalls
    [ffconf.h, log_writer.c]
2026-04-07 fix: SDIO DMA TX_UNDERRUN, reorder ops and burst config
    [canlogger.ioc, log_writer.c, sd_diskio.c]
2026-04-07 fix: address review feedback (.ioc PBURST, SD_TIMEOUT parens)
    [canlogger.ioc, sd_diskio.c]
2026-04-07 refactor: move DMA write fix to BSP override for CubeMX safety
    [bsp_driver_sd.c, canlogger.ioc, sd_diskio.c, sd_write_dma.c]
2026-04-07 feat: SDIO error counters, FAULT diagnostics, CDC fault command
    [debug_out.c, log_writer.c, log_writer.h, sd_write_dma.c, sd_write_dma.h]
2026-04-08 docs: fix SDIO mode (1-bit -> 4-bit), add schematic conventions
2026-04-09 feat: SD write error counters, streaming CDC upload, lw_pause
    [debug_out.c, log_writer.c, log_writer.h, sd_write_dma.c, sd_write_dma.h]
2026-04-09 chore: instrument sd_diskio to diagnose f_sync failures
    [debug_out.c, log_writer.c, log_writer.h, sd_diskio.c, sd_diskio_counters.h]
2026-04-09 fix: SD_status transient PROGRAMMING state blocking f_sync
    [debug_out.c, sd_diskio.c, sd_diskio_counters.h]
2026-04-10 feat: CAN bus diagnostics in status, hybrid stress test config
2026-04-10 docs: stress test results, add dual CAN bus to roadmap
2026-04-10 docs: PPK2 power measurements for supercap sizing
2026-04-10 feat: switch RTC clock source from LSI to LSE
2026-04-18 feat: MLG markers via K0 button and CDC mark command
2026-04-19 docs: document K0 marker button
2026-04-23 feat: plausibility filter for CAN fields
2026-04-23 fix: trim preallocation in recover_file, gate by had_clean_sync
    [log_writer.c]
2026-04-23 chore: drop SCHEMATIC_CONVENTIONS.md
2026-04-24 feat: GPS NMEA logging via USART3 (Variant C hybrid MLG)
    [gps] enable = 1 auto-injects five default fields (lat/lon/alt/speed_kmh/fix);
    extra NMEA tags opt-in via [field] source = gps:<tag>. can_map_update_gps
    packs gps_State into field_values honoring partial-fix has_* flags.
    gps_nmea parser (GGA/RMC) is host-testable; gps_drv runs USART3 @ 9600 8N1
    on DMA1_Stream1 circular RX with NDTR polling from task_producer. One-shot
    RTC sync on first fix with date+time. CDC: gps (snapshot), gps_raw (toggle
    NMEA passthrough). Buffer lives in main SRAM because DMA1 can't reach CCM.
    [canlogger.ioc, debug_out.c, gps_drv.c, gps_drv.h, main.c, test_can_map.c, test_config.c, test_gps_nmea.c]
2026-04-24 fix(gps): drain poll outside shadow_mutex, clear ORE on init
    gps_drv_poll() only mutates task_producer-local state (DMA read pos,
    line buffer, gps_State, counters), so it does not need the shadow_mutex.
    When gps_raw is ON it also putchars each received byte to CDC — holding
    the mutex through USB TX would stall task_sd's field_values snapshot.
    MX_USART3_UART_Init() enables RE well before StartDefaultTask runs;
    any NMEA byte received in that window latches ORE in USART_SR, which
    HAL_UART_Receive_DMA does not clear. Drain SR+DR via
    __HAL_UART_CLEAR_OREFLAG before arming the DMA.
    [gps_drv.c, main.c]
2026-04-24 docs: sync roadmap with shipped hat prototype and stress test
    - HAT_PROTOTYPE.md: TODO → Status, breadboard validation complete
    - REQUIREMENTS.md hat PCB: cite PPK2 sizing (94 mA / 150 ms / 0.47 F) and
    breadboard, flag DC-DC choice as still open
    - REQUIREMENTS.md stress test: cite 2 h 27 min / 65 M frames / 0 err run
    and link STRESS_TEST_128U16_PLAN.md
